Golowa70/CAR_BS_CONTROLLER_ST7920/README.md

# CAR_BS_CONTROLLER_ST7920
Контроллер дополнительного 
оборудования автомобиля описанного в https://github.com/Golowa70/CAR-BS-CONTROLLER-NEX
Используется то же железо но вместо nextion применён дисплей ST7920 + три кнопки
для навигации по меню.
