Golowa70/CAR_BS_CONTROLLER_ST7920/KiCad/Car_bs_controller_nex_mega__v3.pdf

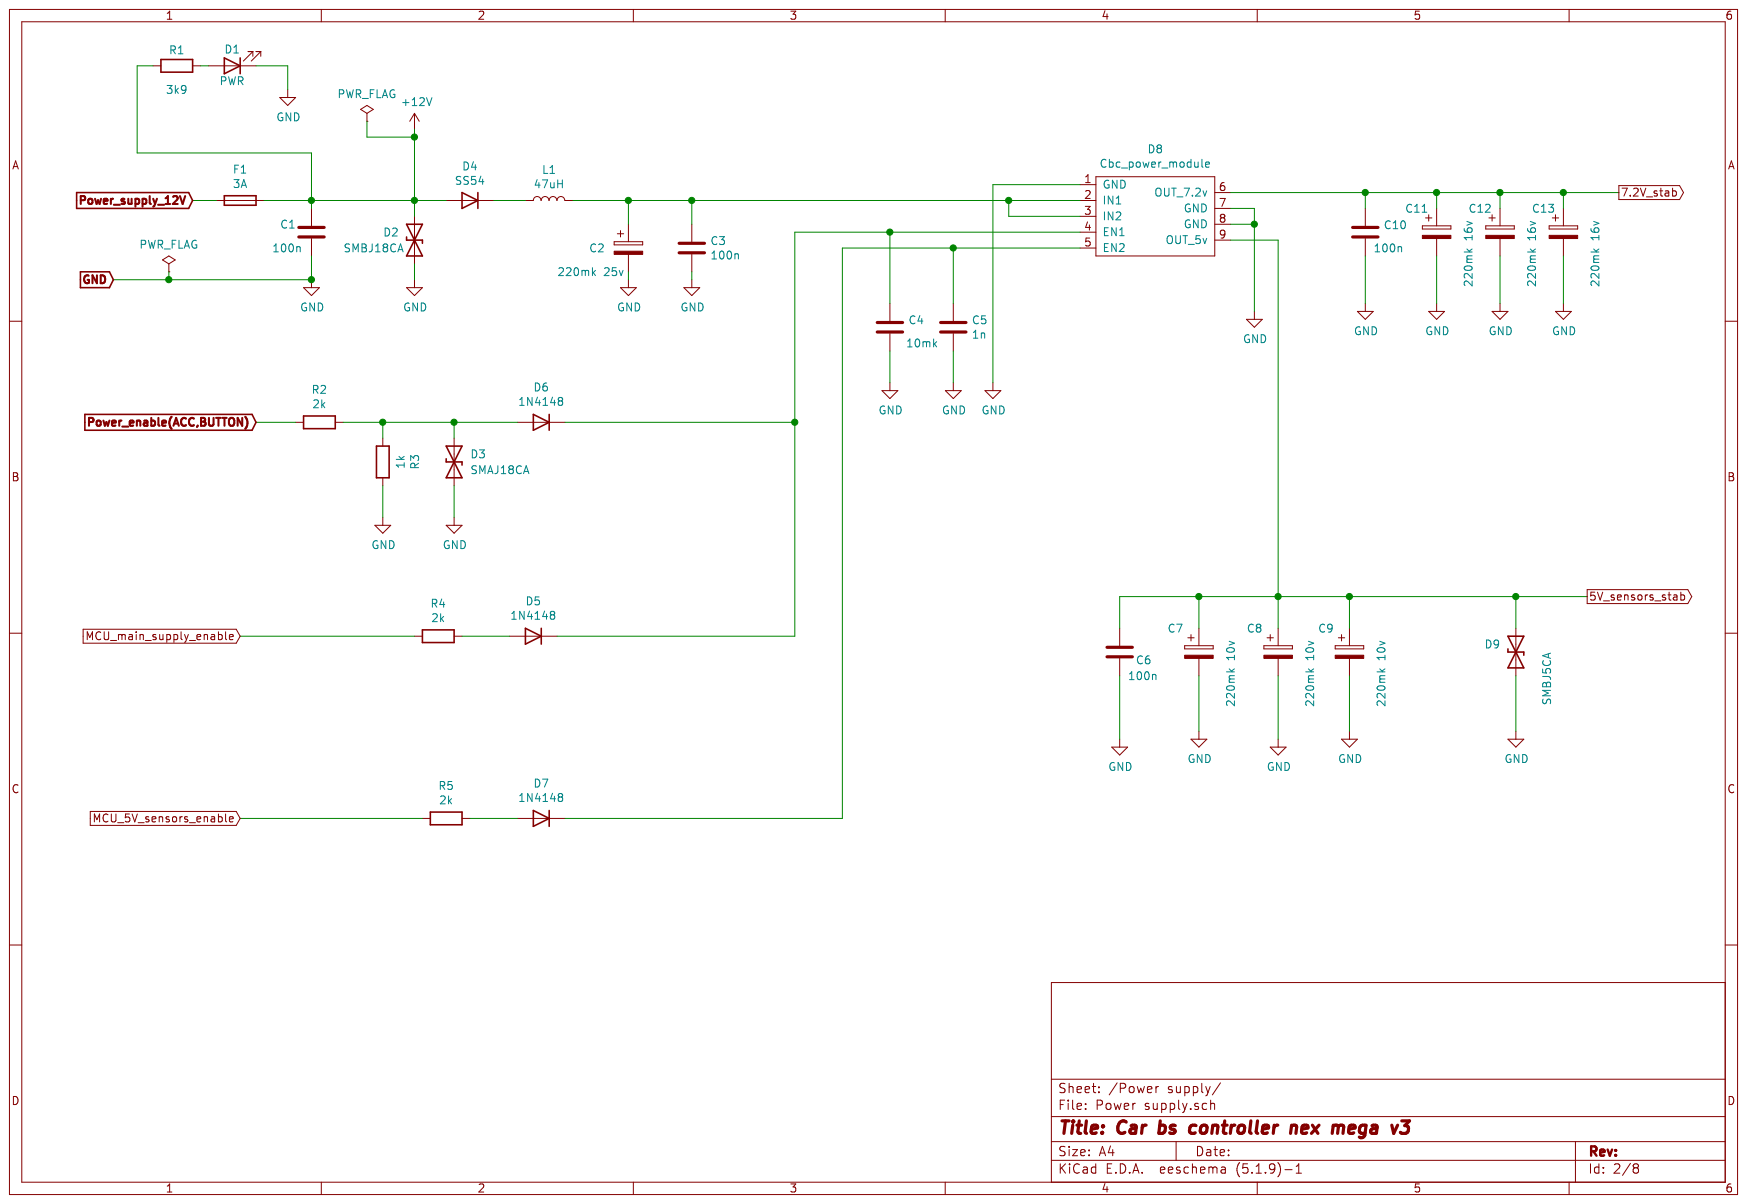
[picture p1: page 1]

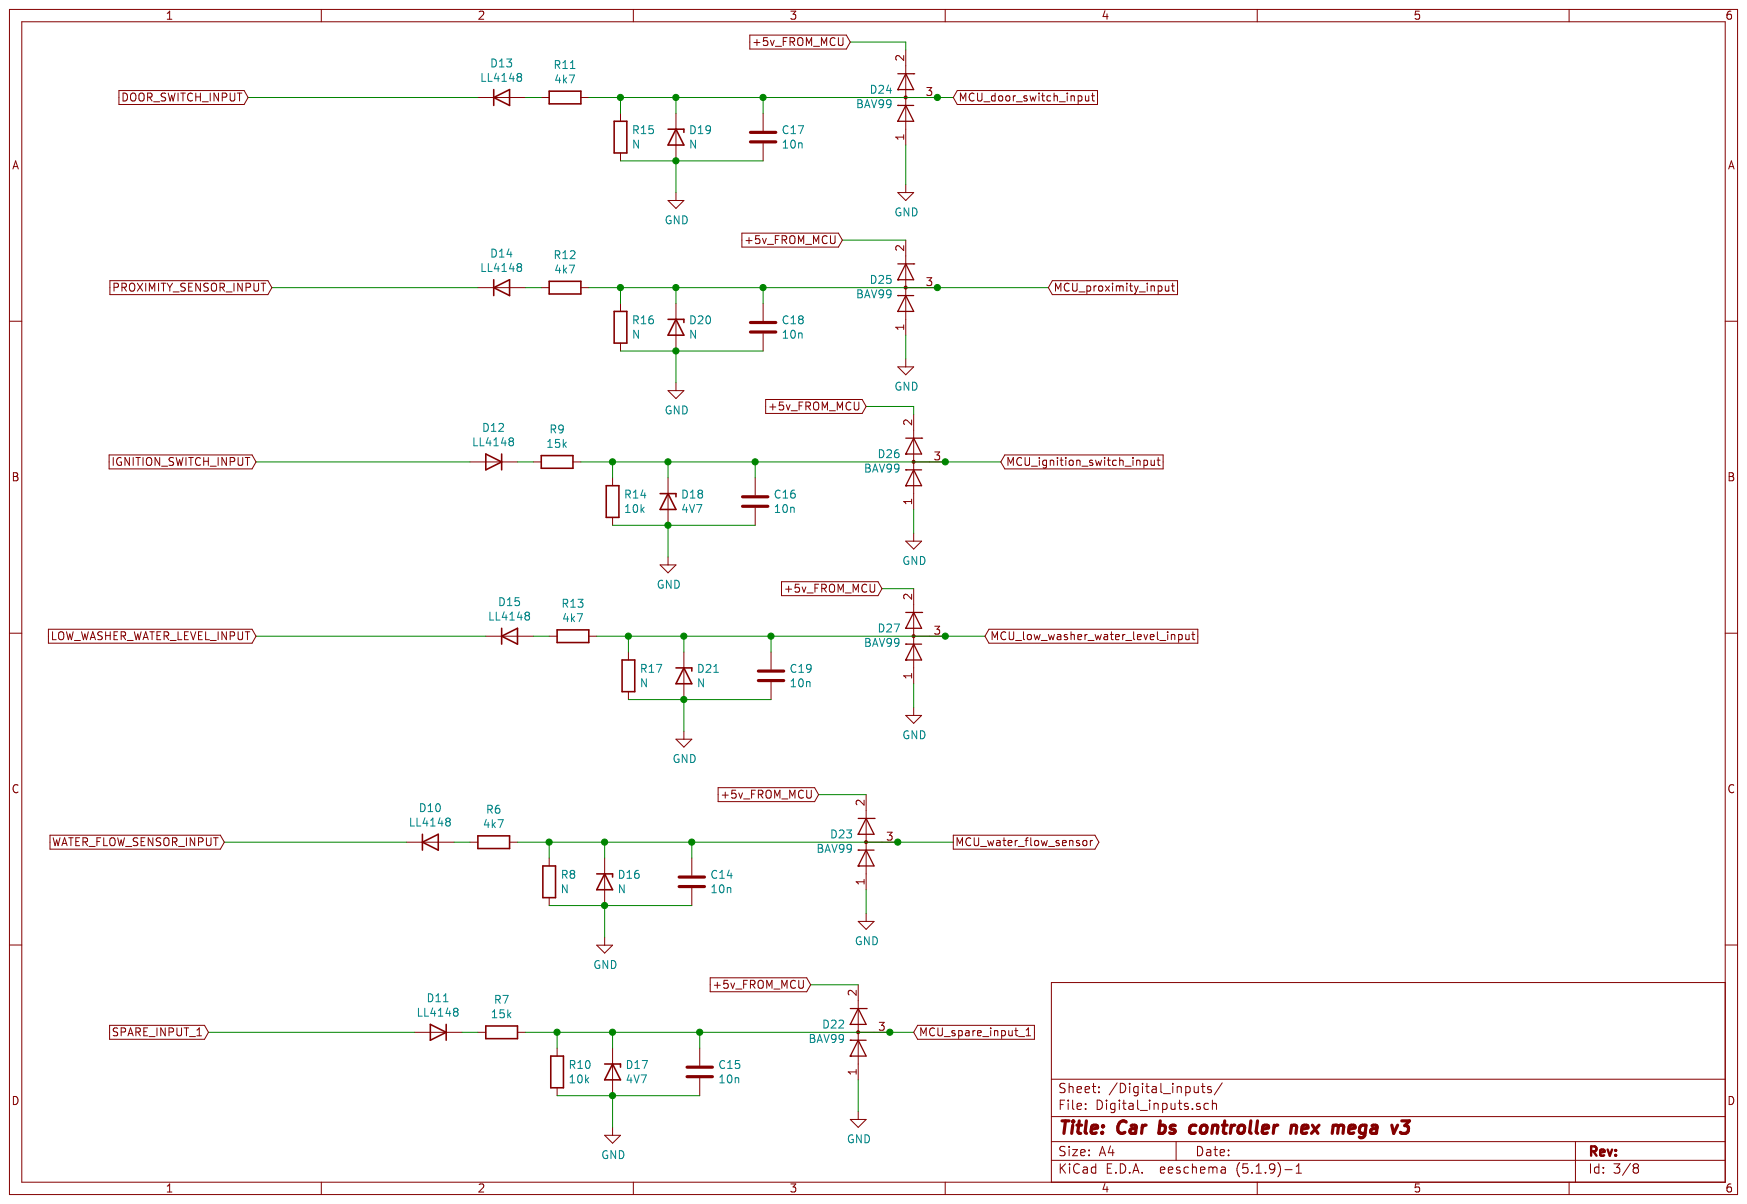
[picture p2: page 2]

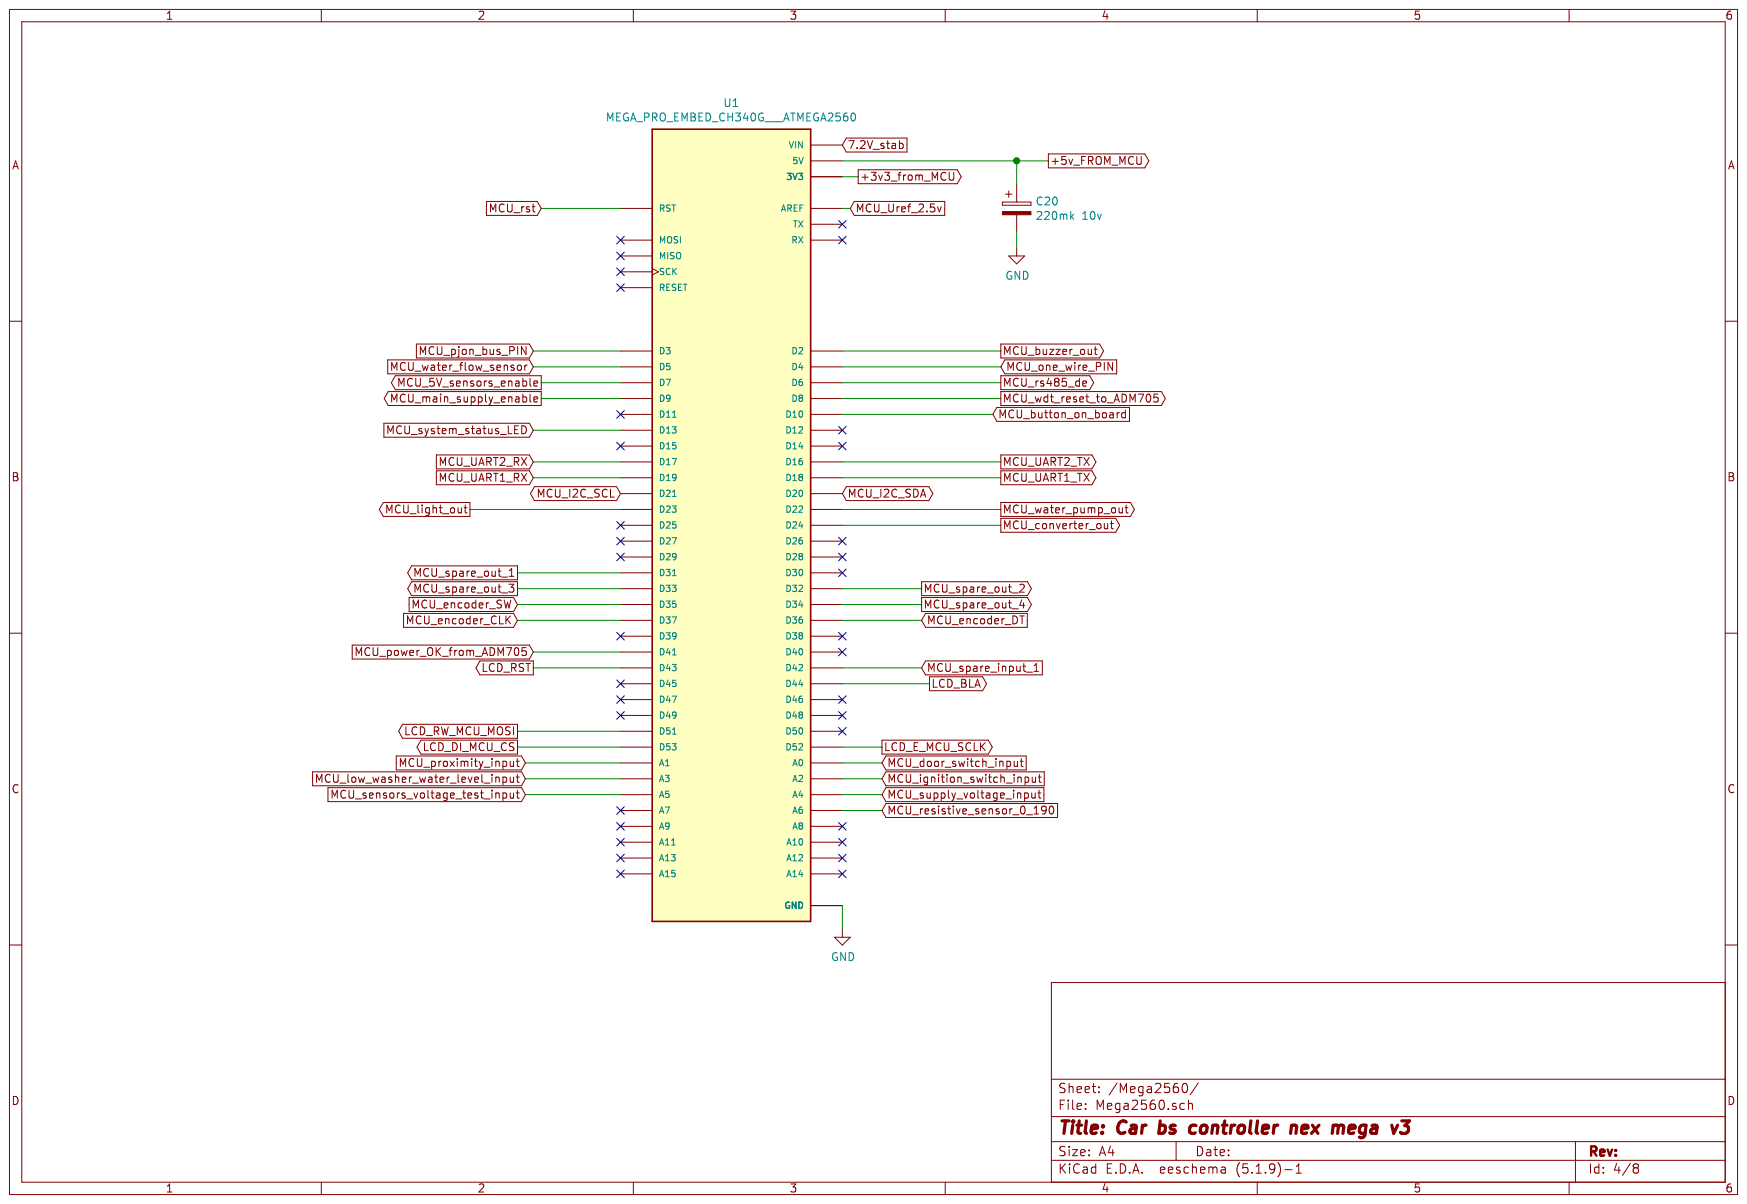
[picture p3: page 3]

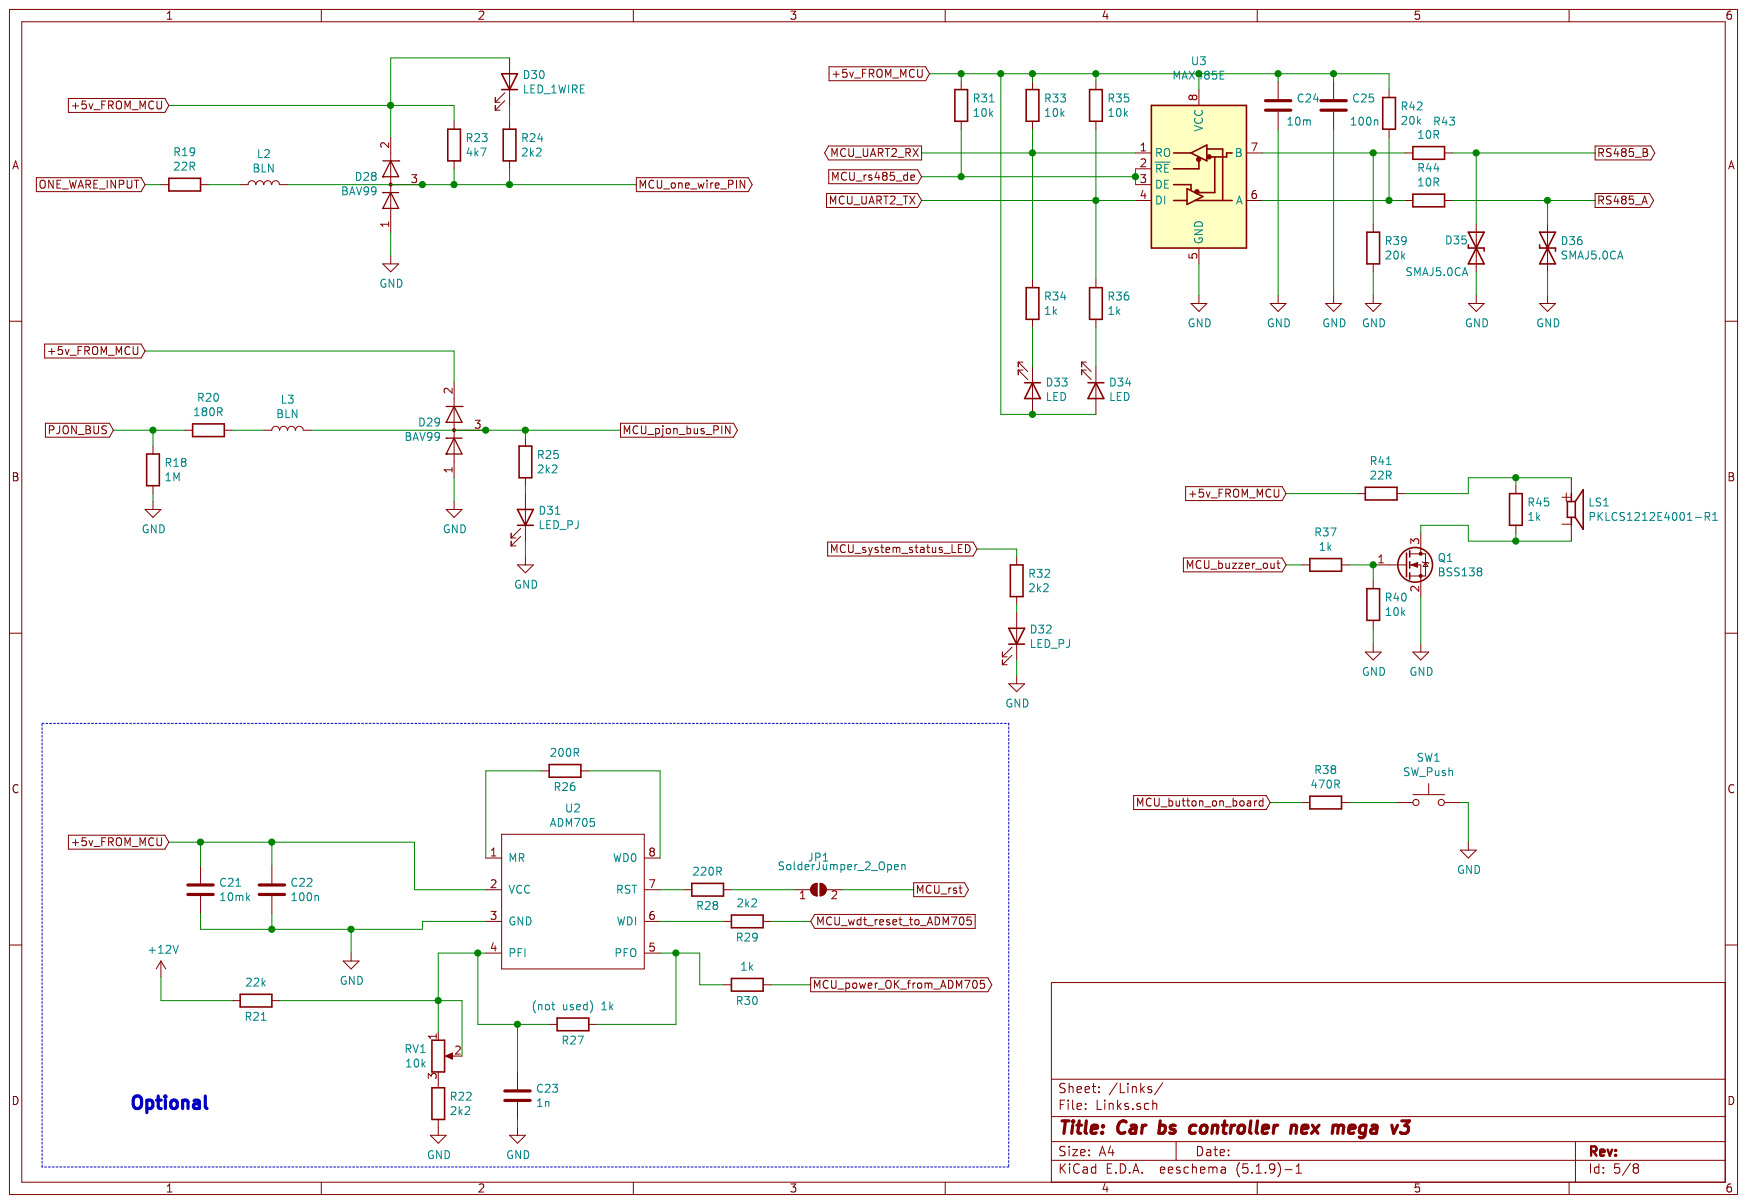
[picture p4: page 4]

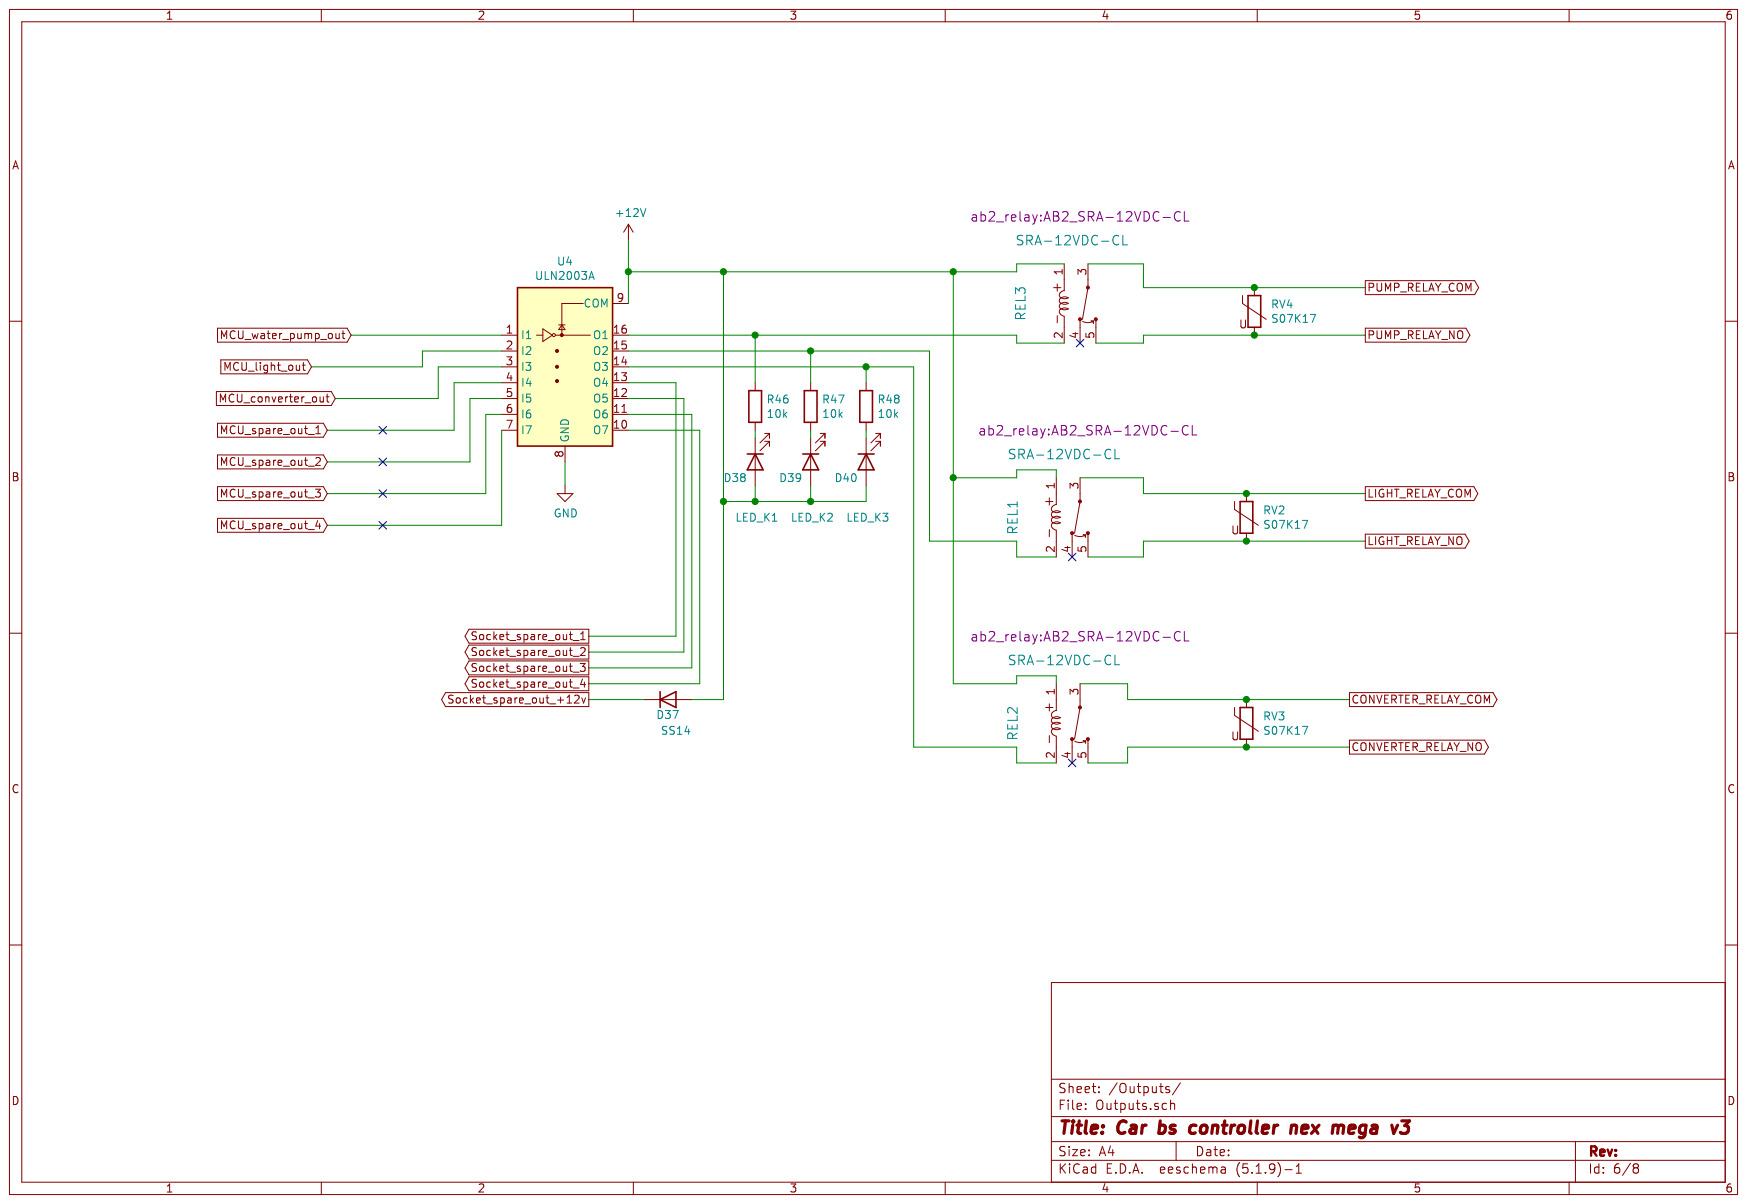
[picture p5: page 5]

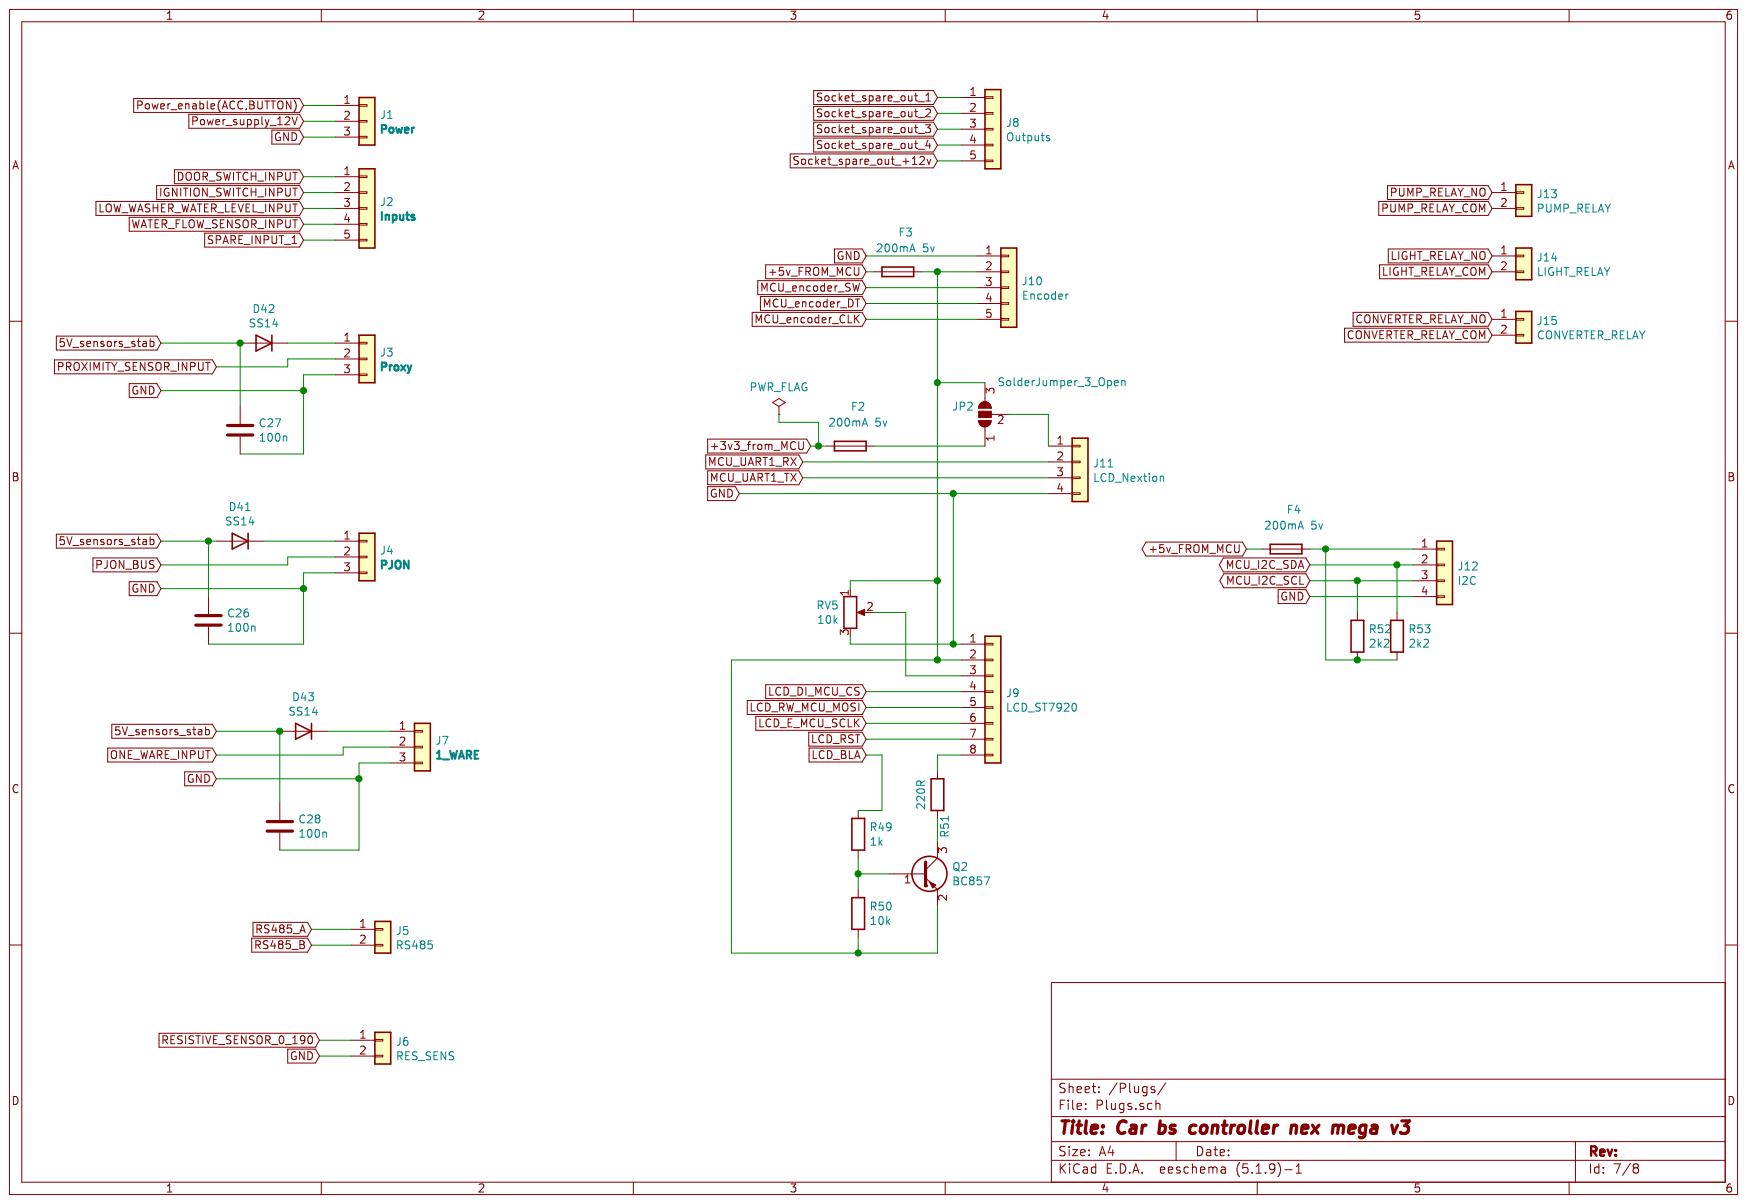
[picture p6: page 6]

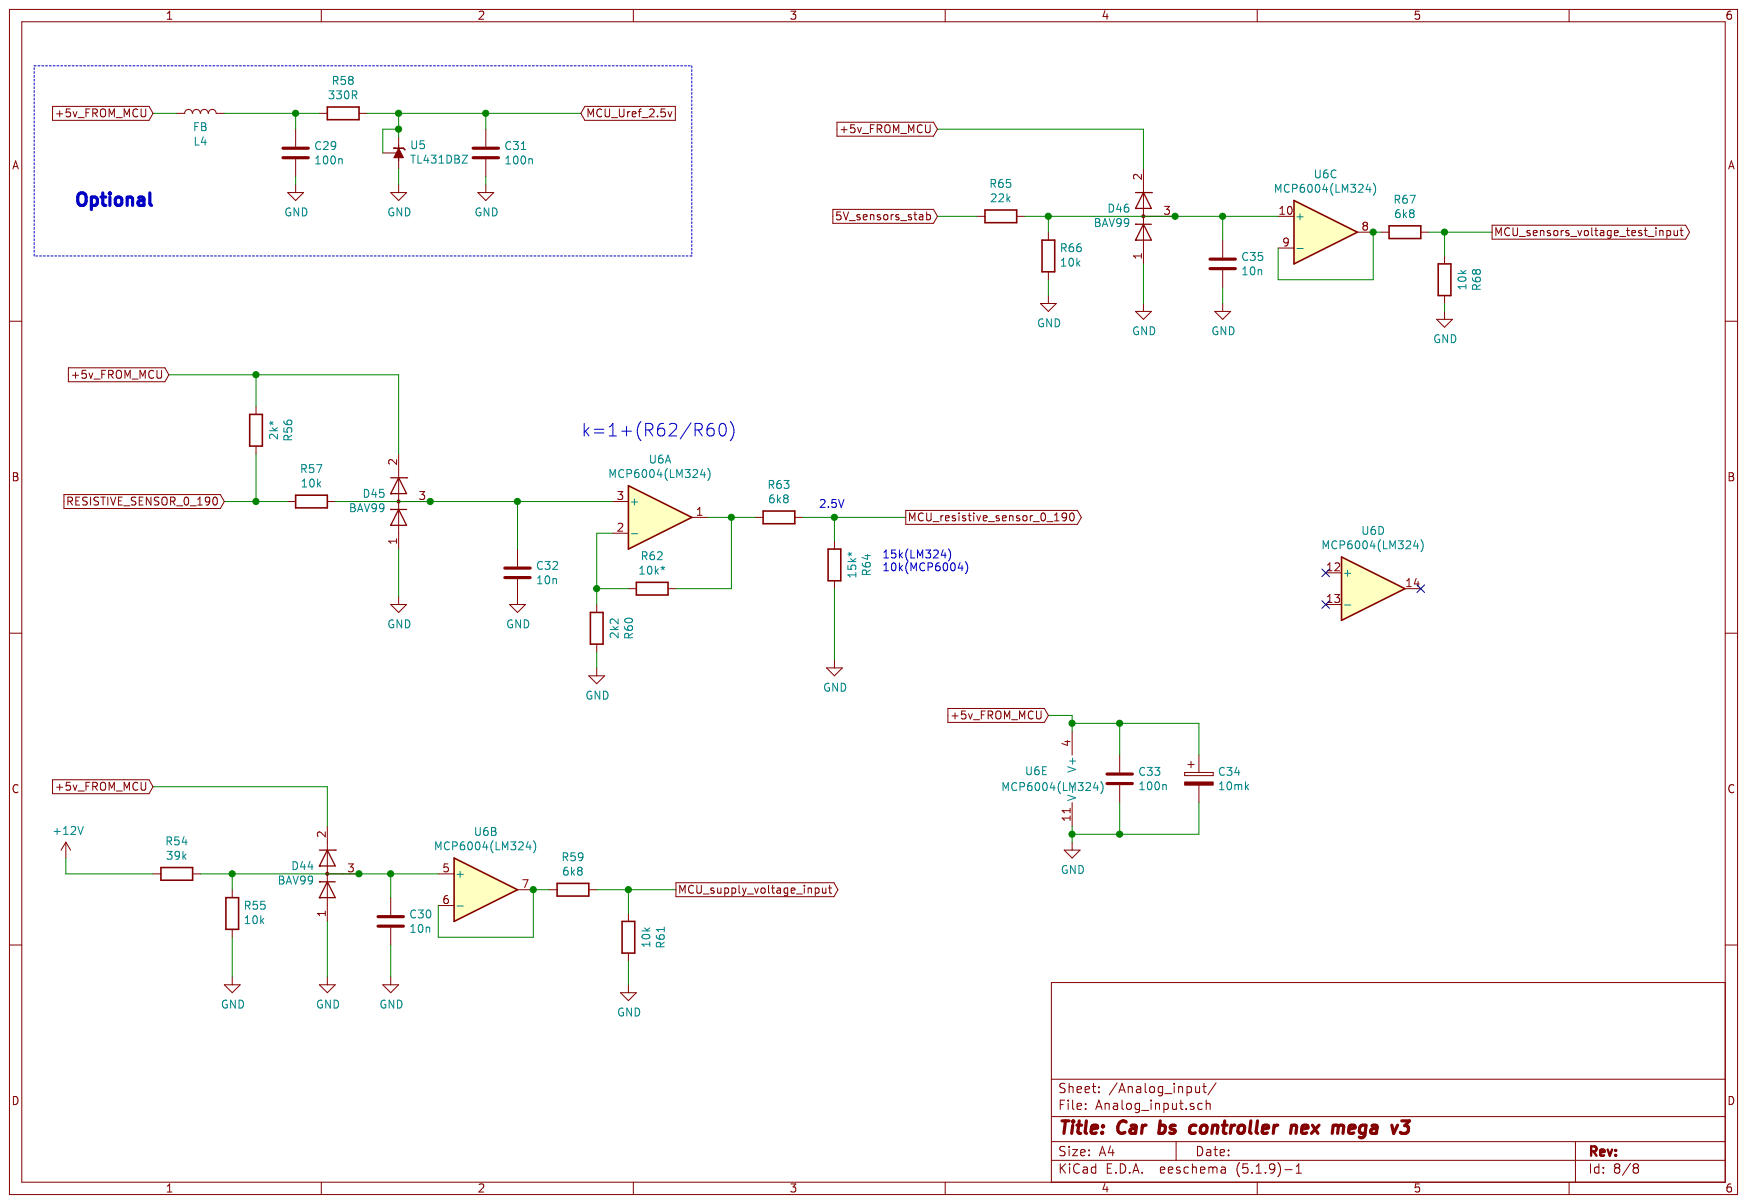
[picture p7: page 7]
