Golowa70/CAR_BS_CONTROLLER_ST7920/KiCad/Cbc_power_supply_module.pdf

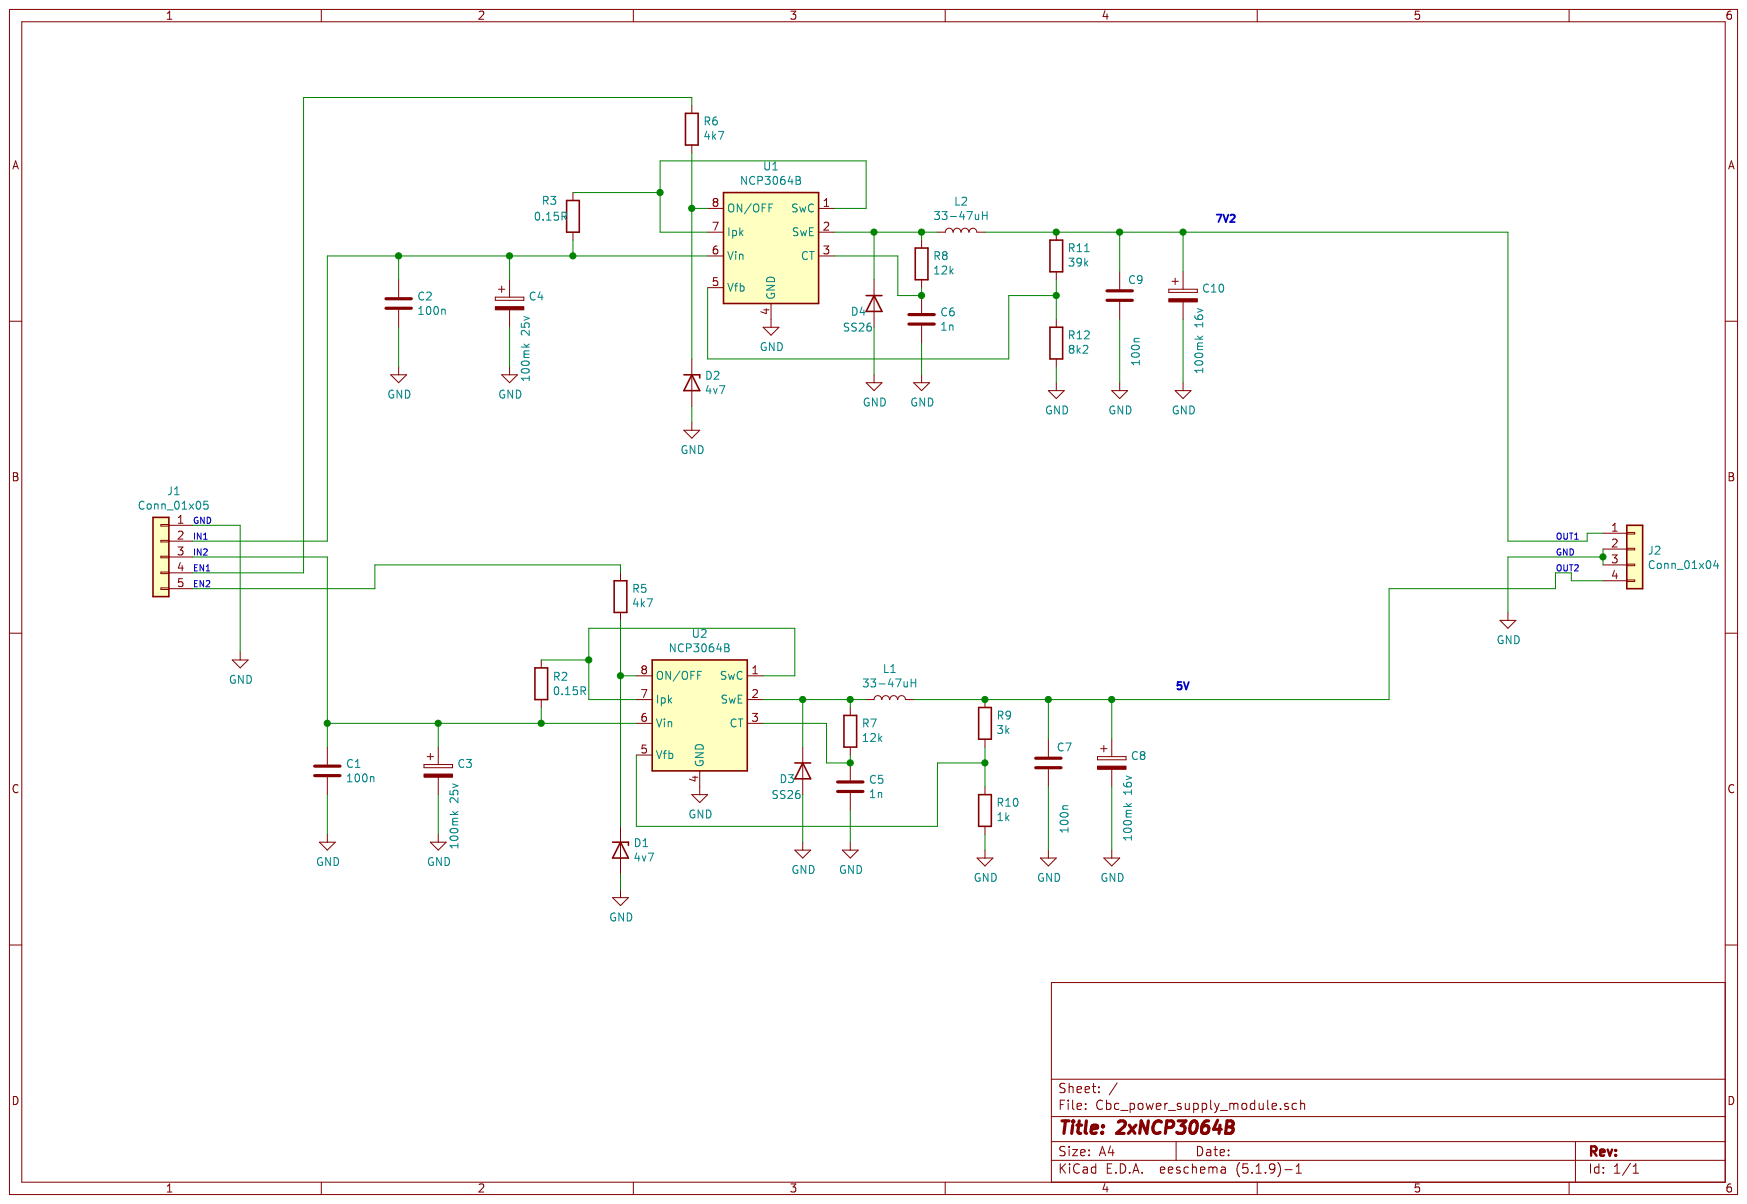
[picture p8: page 1]
