Golowa70/CAR_BS_CONTROLLER_ST7920/sPlan/CAR_BS_CONTROLLER_V3_connectors.pdf

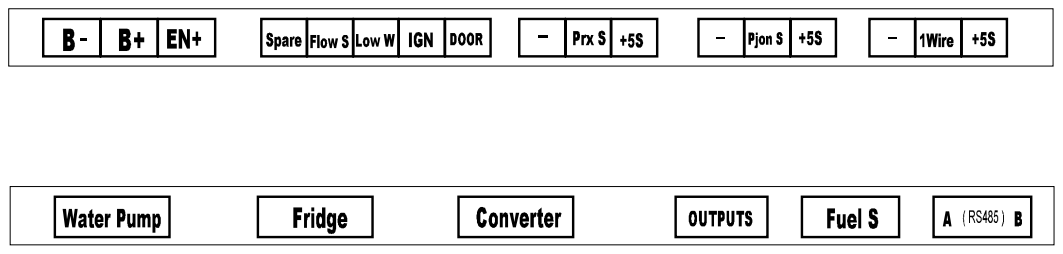
[picture p9: page 1]
