Golowa70/CAR_BS_CONTROLLER_ST7920/sPlan/CAR_BS_CONTROLLER_V3_diagram.pdf

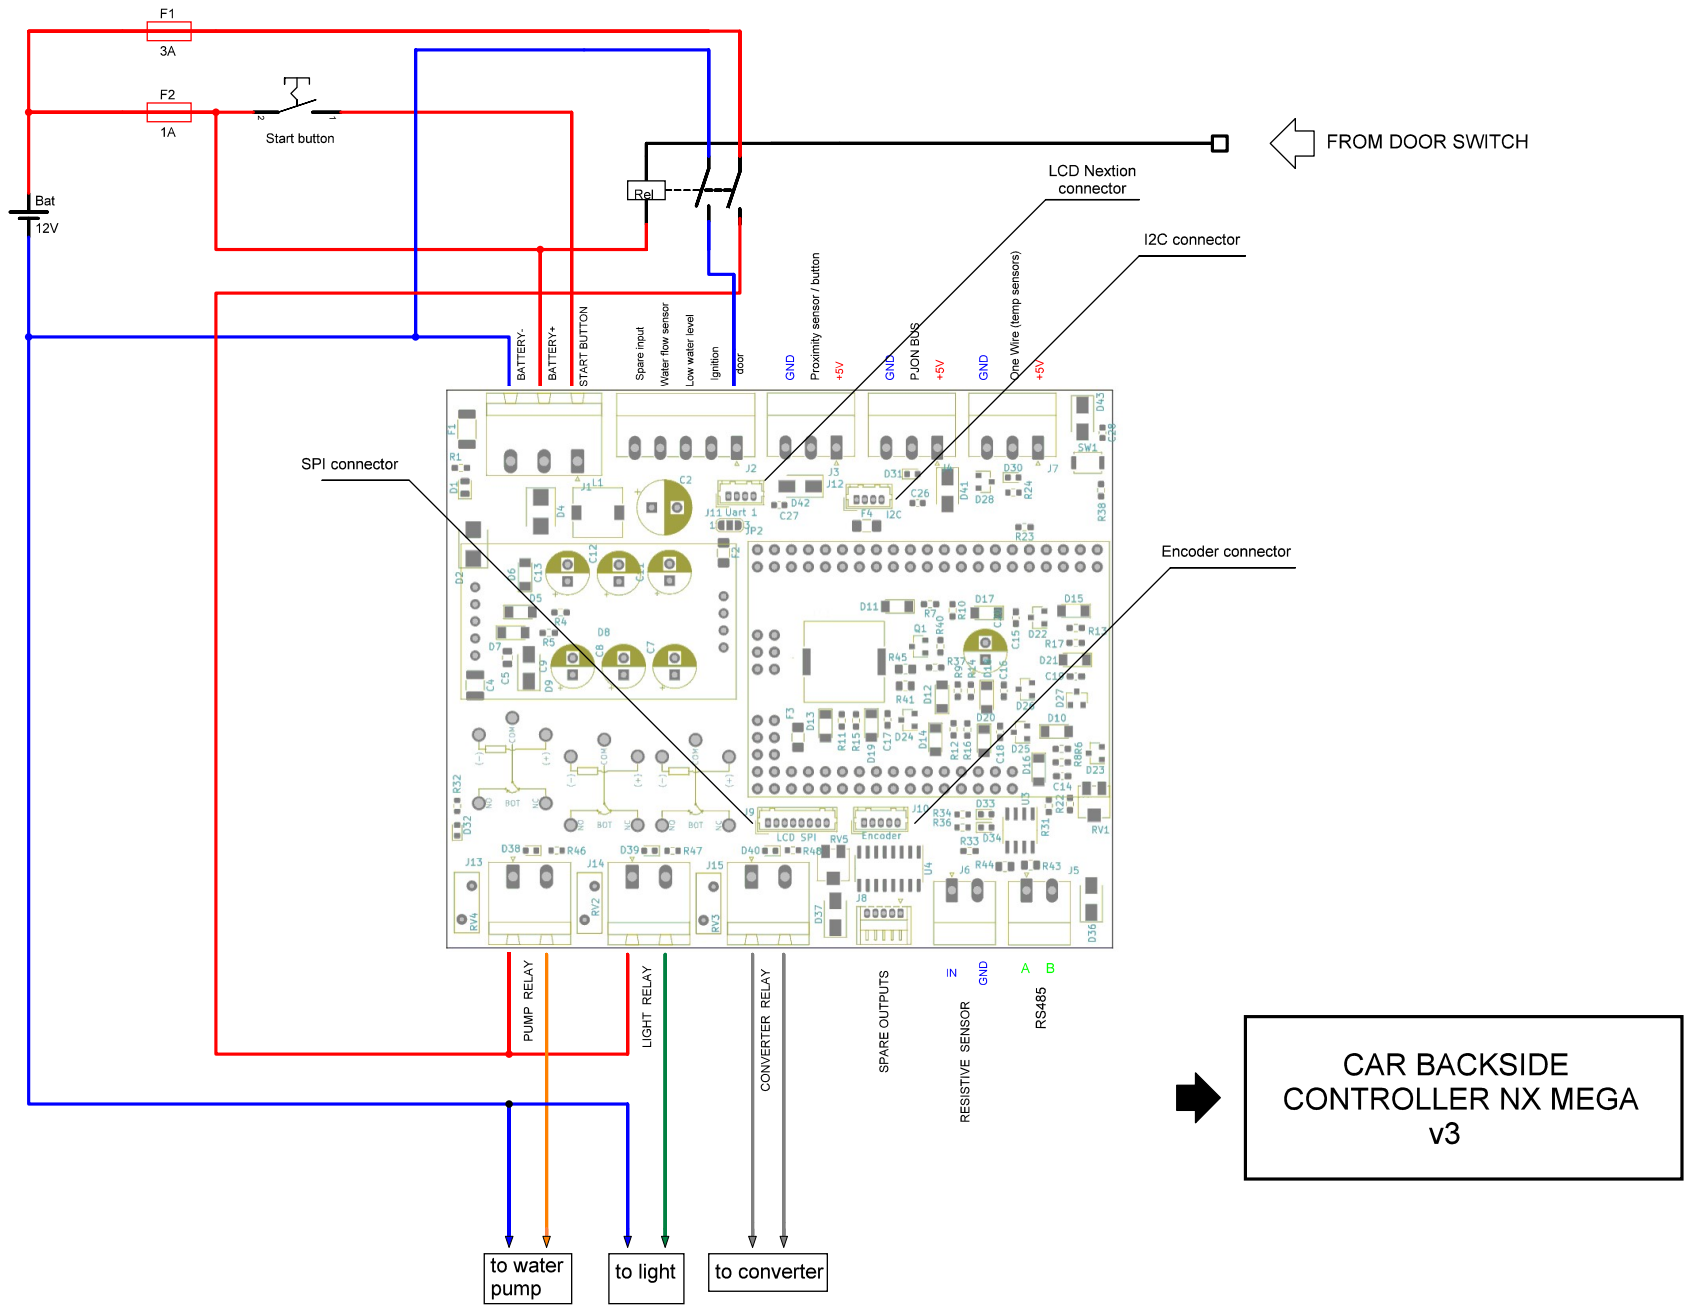
[picture p10: page 1]
