Golowa70/CAR_BS_CONTROLLER_ST7920/(list of files, drawings)

Other design files:
sPlan/Car_bs_controller_connectors.spl7
sPlan/Car_bs_controller_logo.spl7
sPlan/Car_bs_controller_nex_instal_diagram.spl7
