Golowa70/CAR_BS_CONTROLLER_ST7920/KiCad/Car_bs_controller_nex_mega/Car_bs_controller_nex_mega.kicad_pcb

## KiCad design KiCad/Car_bs_controller_nex_mega/Car_bs_controller_nex_mega.kicad_pcb (2022-05-16)

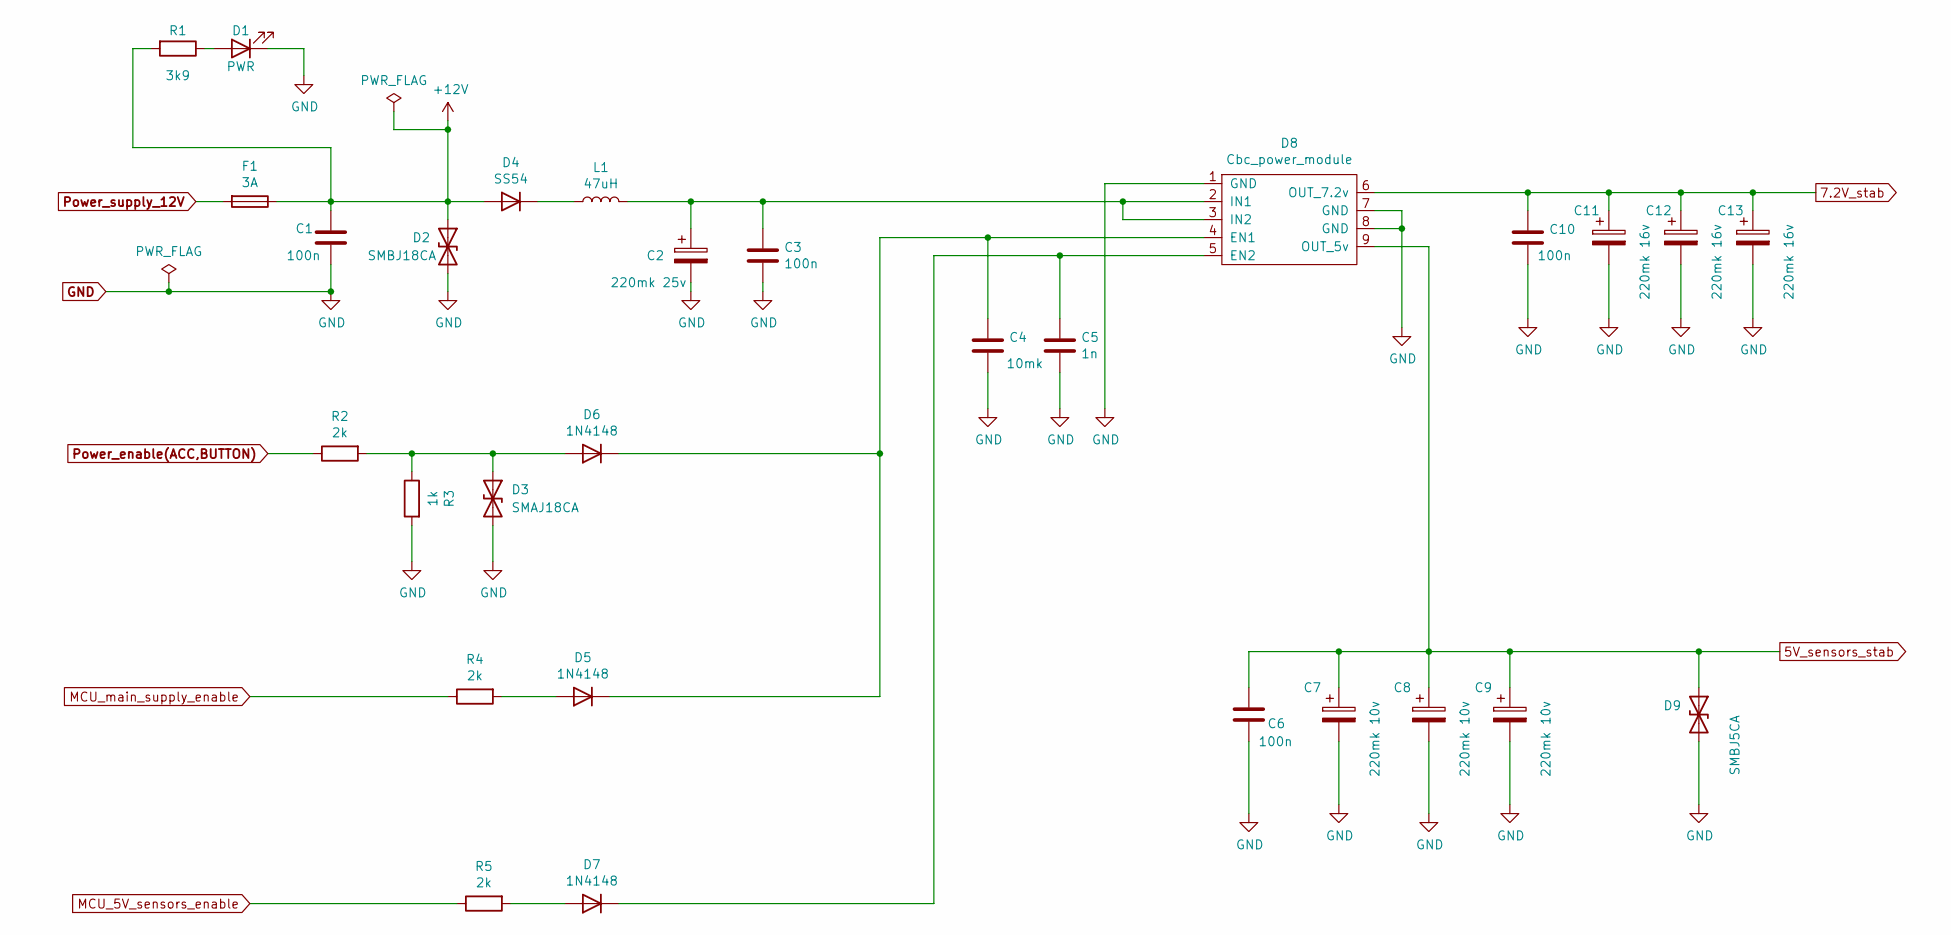
[picture p19: schematic Power supply.sch, Car bs controller nex mega v3]

Parts:
C1, C3, C6, C10: 100n; C_0805_2012Metric
C2: 220mk 25v; CP_Radial_D8.0mm_P3.80mm
C4: 10mk; C_1210_3225Metric_Pad1.33x2.70mm_HandSolder
C5: 1n; C_0805_2012Metric
C7, C8, C9: 220mk 10v; CP_Radial_D6.3mm_P2.50mm
C11, C12, C13: 220mk 16v; CP_Radial_D6.3mm_P2.50mm
D1: PWR; LED_0805_2012Metric
D2: SMBJ18CA; D_SMB
D3: SMAJ18CA; D_SMA
D4: SS54; D_SMB
D5, D6, D7: 1N4148; D_MiniMELF
D8: Cbc_power_module
D9: SMBJ5CA; D_SMA
F1: 3A; Fuse_2010_5025Metric
L1: 47uH; L_7.3x7.3_H4.5
R1: 3k9; R_0603_1608Metric_Pad0.98x0.95mm_HandSolder
R2, R4, R5: 2k; R_0603_1608Metric_Pad0.98x0.95mm_HandSolder
R3: 1k; R_0603_1608Metric_Pad0.98x0.95mm_HandSolder

Connections:
5V_sensors_stab: C6.1, C7.1, C8.1, C9.1, D8.9 (OUT_5v), D9.1 (A1); also elsewhere on the board
7.2V_stab: C10.1, C11.1, C12.1, C13.1, D8.6 (OUT_7.2v); also elsewhere on the board
+12V: C1.1, D2.1 (A1), D4.2 (A), F1.1, R1.2; also elsewhere on the board
GND: C1.2, C2.2, C3.2, C4.2, C5.2, C6.2, C7.2, C8.2, C9.2, C10.2, C11.2, C12.2, C13.2, D1.1 (K), D2.2 (A2), D3.2 (A2), D8.1 (GND), D8.7 (GND), D8.8 (GND), D9.2 (A2), R3.2; also elsewhere on the board
MCU_5V_sensors_enable: R5.1; also elsewhere on the board
MCU_main_supply_enable: R4.1; also elsewhere on the board
unnamed: C2.1, C3.1, D8.2 (IN1), D8.3 (IN2), L1.2
unnamed: C4.1, D5.1 (K), D6.1 (K), D8.4 (EN1)
unnamed: C5.1, D7.1 (K), D8.5 (EN2)
unnamed: D1.2 (A), R1.1
unnamed: D3.1 (A1), D6.2 (A), R2.2, R3.1
unnamed: D4.1 (K), L1.1
unnamed: D5.2 (A), R4.2
unnamed: D7.2 (A), R5.2
Power_enable(ACC,BUTTON): R2.1; also elsewhere on the board
Power_supply_12V: F1.2; also elsewhere on the board

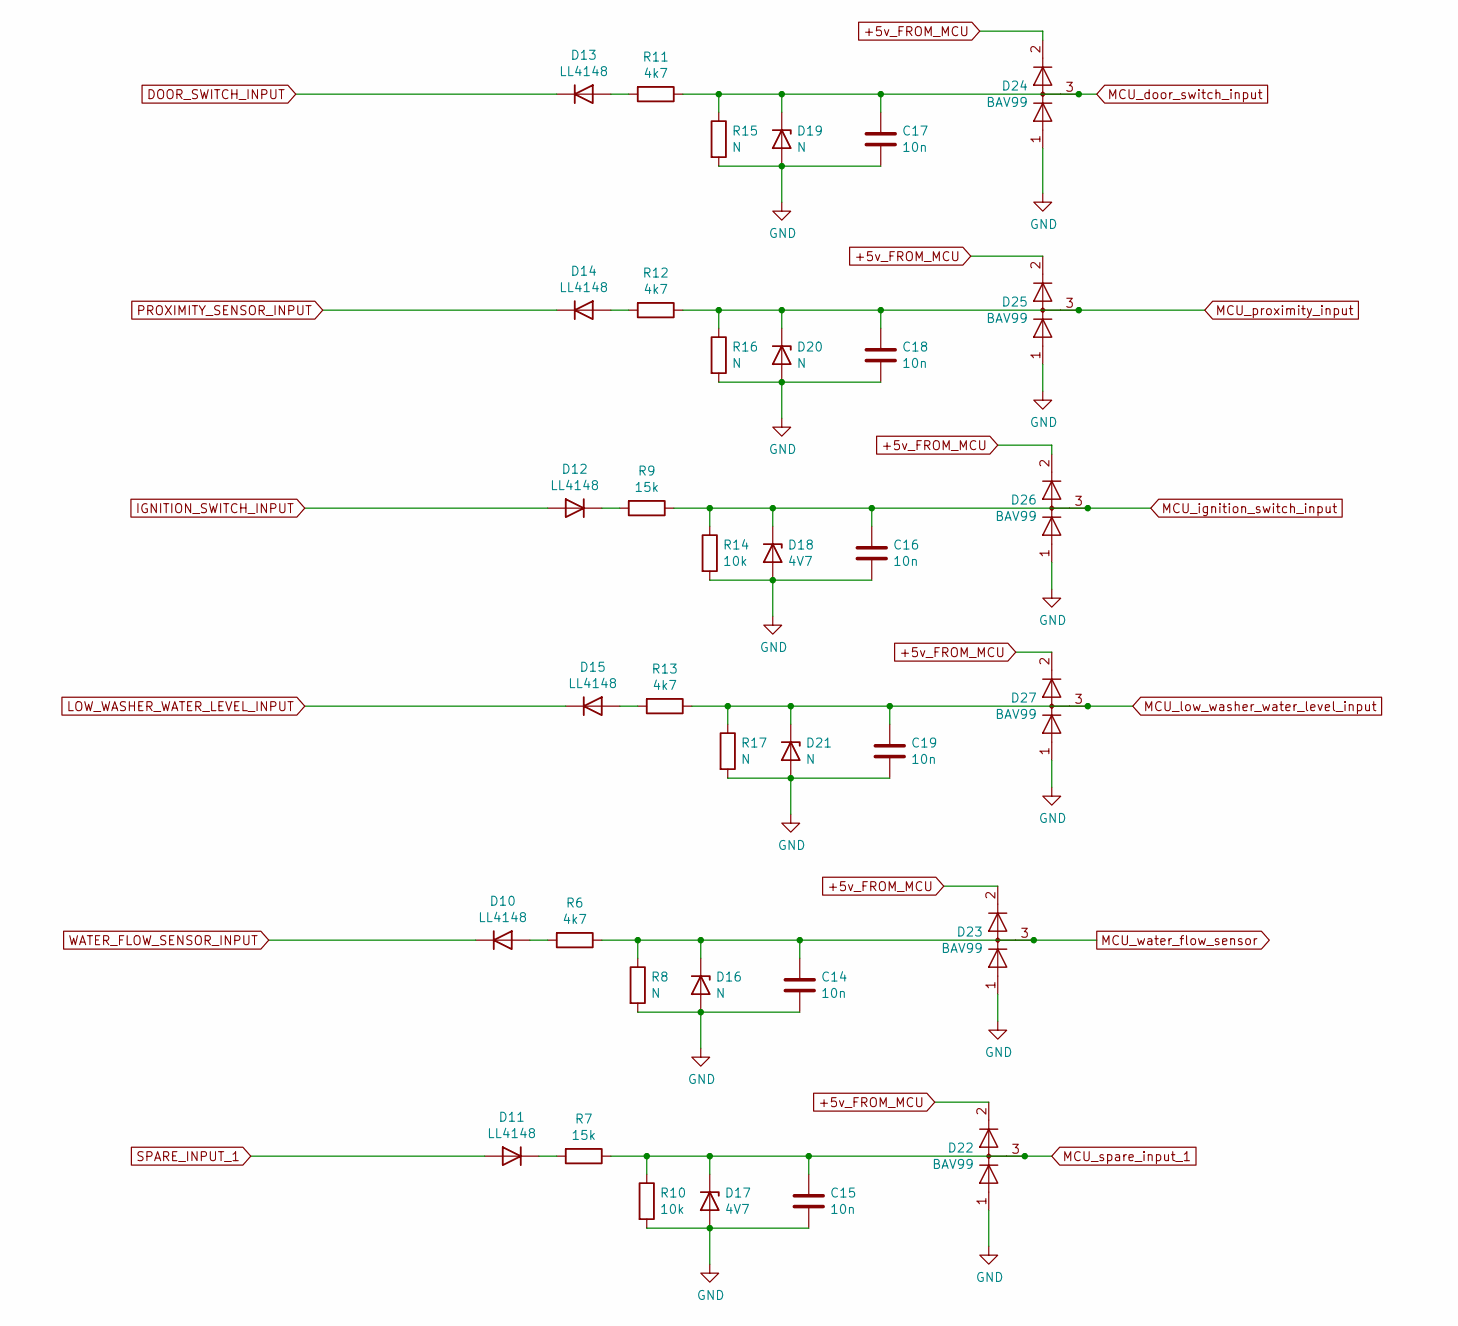
[picture p20: schematic Digital_inputs.sch, Car bs controller nex mega v3]

Parts:
C14, C15, C16, C17, C18, C19: 10n; C_0603_1608Metric_Pad1.08x0.95mm_HandSolder
D10, D11, D12, D13, D14, D15: LL4148; D_MiniMELF
D16, D19, D20, D21: N; D_MiniMELF
D17, D18: 4V7; D_MiniMELF
D22, D23, D24, D25, D26, D27: BAV99; SOT-23
R6, R11, R12, R13: 4k7; R_0603_1608Metric_Pad0.98x0.95mm_HandSolder
R7, R9: 15k; R_0603_1608Metric_Pad0.98x0.95mm_HandSolder
R8, R15, R16, R17: N; R_0603_1608Metric_Pad0.98x0.95mm_HandSolder
R10, R14: 10k; R_0603_1608Metric_Pad0.98x0.95mm_HandSolder

Connections:
+5v_FROM_MCU: D22.2 (A), D23.2 (A), D24.2 (A), D25.2 (A), D26.2 (A), D27.2 (A); also elsewhere on the board
DOOR_SWITCH_INPUT: D13.1 (K); also elsewhere on the board
GND: C14.2, C15.2, C16.2, C17.2, C18.2, C19.2, D16.2 (A), D17.2 (A), D18.2 (A), D19.2 (A), D20.2 (A), D21.2 (A), D22.1 (K), D23.1 (K), D24.1 (K), D25.1 (K), D26.1 (K), D27.1 (K), R8.2, R10.2, R14.2, R15.2, R16.2, R17.2; also elsewhere on the board
IGNITION_SWITCH_INPUT: D12.2 (A); also elsewhere on the board
LOW_WASHER_WATER_LEVEL_INPUT: D15.1 (K); also elsewhere on the board
MCU_door_switch_input: C17.1, D19.1 (K), D24.3 (K), R11.1, R15.1; also elsewhere on the board
MCU_ignition_switch_input: C16.1, D18.1 (K), D26.3 (K), R9.1, R14.1; also elsewhere on the board
MCU_low_washer_water_level_input: C19.1, D21.1 (K), D27.3 (K), R13.1, R17.1; also elsewhere on the board
MCU_proximity_input: C18.1, D20.1 (K), D25.3 (K), R12.1, R16.1; also elsewhere on the board
MCU_spare_input_1: C15.1, D17.1 (K), D22.3 (K), R7.1, R10.1; also elsewhere on the board
MCU_water_flow_sensor: C14.1, D16.1 (K), D23.3 (K), R6.1, R8.1; also elsewhere on the board
unnamed: D10.2 (A), R6.2
unnamed: D11.1 (K), R7.2
unnamed: D12.1 (K), R9.2
unnamed: D13.2 (A), R11.2
unnamed: D14.2 (A), R12.2
unnamed: D15.2 (A), R13.2
PROXIMITY_SENSOR_INPUT: D14.1 (K); also elsewhere on the board
SPARE_INPUT_1: D11.2 (A); also elsewhere on the board
WATER_FLOW_SENSOR_INPUT: D10.1 (K); also elsewhere on the board

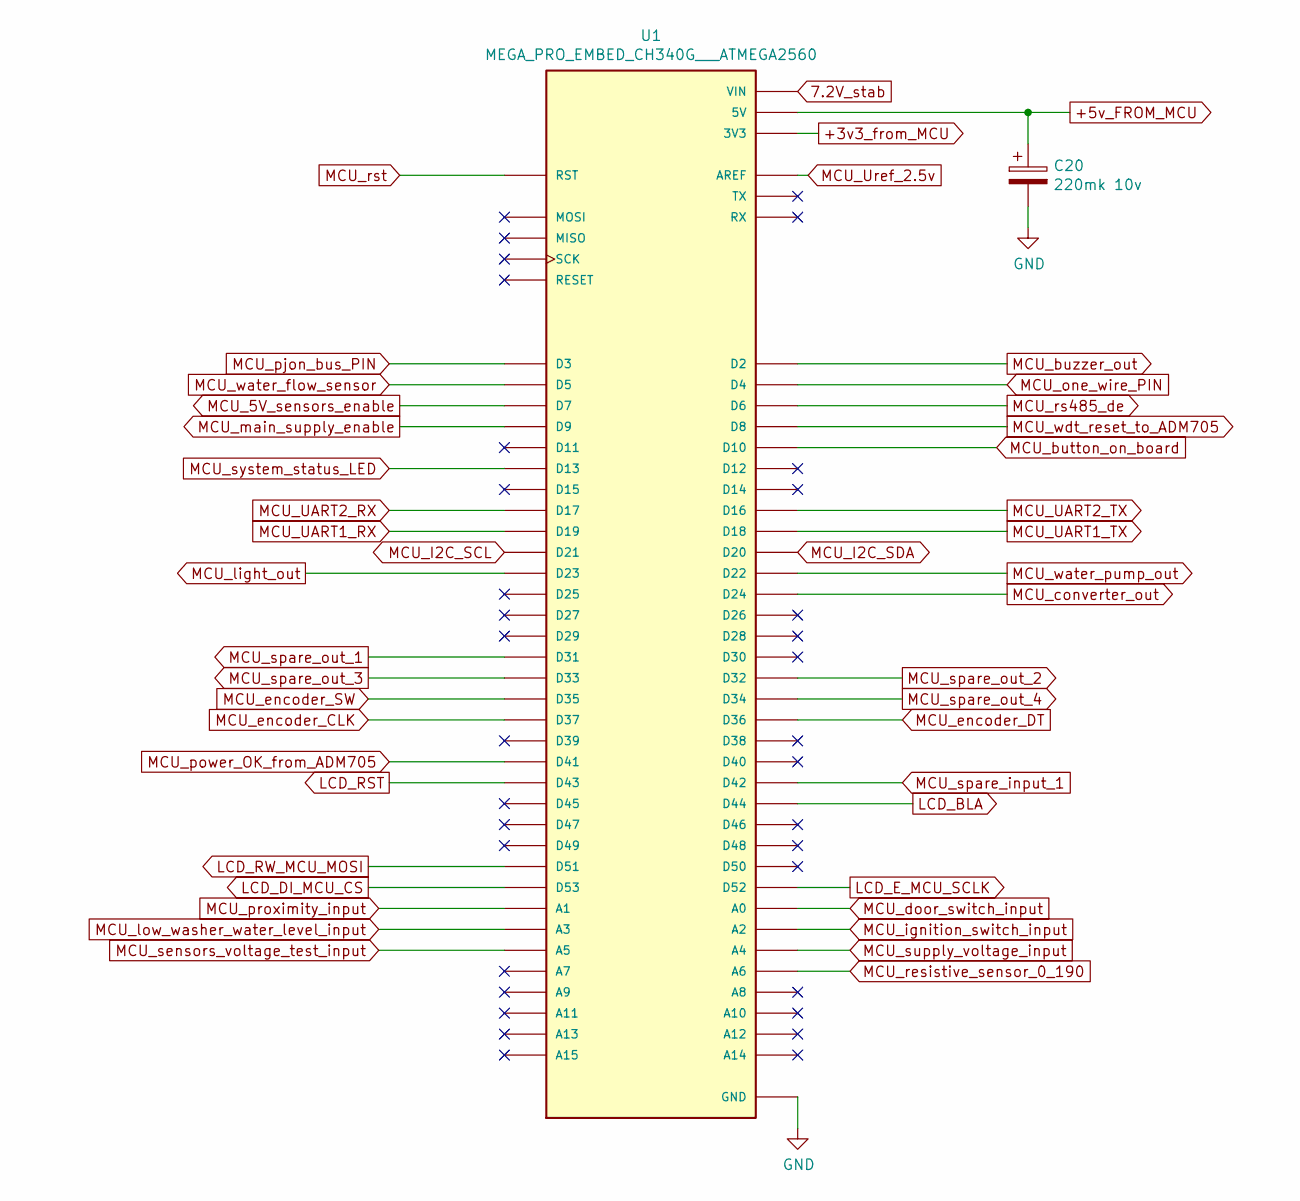
[picture p21: schematic Mega2560.sch, Car bs controller nex mega v3]

Parts:
C20: 220mk 10v; CP_Radial_D6.3mm_P2.50mm
U1: MEGA_PRO_EMBED_CH340G___ATMEGA2560; _ATMEGA2560; PARTREV 12/May/2017

Connections:
7.2V_stab: U1.VIN_1 (VIN); also elsewhere on the board
+3v3_from_MCU: U1.3V3_1 (3V3), U1.3V3_2 (3V3); also elsewhere on the board
+5v_FROM_MCU: C20.1, U1.5V_1 (5V); also elsewhere on the board
GND: C20.2, U1.GND_1 (GND), U1.GND_2 (GND), U1.GND_3 (GND); also elsewhere on the board
LCD_BLA: U1.D44; also elsewhere on the board
LCD_E_MCU_SCLK: U1.D52; also elsewhere on the board
LCD_RST: U1.D43; also elsewhere on the board
LCD_RW_MCU_MOSI: U1.D51; also elsewhere on the board
MCU_5V_sensors_enable: U1.D7; also elsewhere on the board
MCU_I2C_SCL: U1.D21; also elsewhere on the board
MCU_I2C_SDA: U1.D20; also elsewhere on the board
MCU_UART1_RX: U1.D19; also elsewhere on the board
MCU_UART1_TX: U1.D18; also elsewhere on the board
MCU_UART2_RX: U1.D17; also elsewhere on the board
MCU_UART2_TX: U1.D16; also elsewhere on the board
MCU_Uref_2.5v: U1.AREF; also elsewhere on the board
MCU_button_on_board: U1.D10; also elsewhere on the board
MCU_buzzer_out: U1.D2; also elsewhere on the board
MCU_converter_out: U1.D24; also elsewhere on the board
MCU_door_switch_input: U1.A0; also elsewhere on the board
MCU_encoder_CLK: U1.D37; also elsewhere on the board
MCU_encoder_DT: U1.D36; also elsewhere on the board
MCU_encoder_SW: U1.D35; also elsewhere on the board
MCU_ignition_switch_input: U1.A2; also elsewhere on the board
MCU_light_out: U1.D23; also elsewhere on the board
MCU_low_washer_water_level_input: U1.A3; also elsewhere on the board
MCU_main_supply_enable: U1.D9; also elsewhere on the board
MCU_one_wire_PIN: U1.D4; also elsewhere on the board
MCU_pjon_bus_PIN: U1.D3; also elsewhere on the board
MCU_power_OK_from_ADM705: U1.D41; also elsewhere on the board
MCU_proximity_input: U1.A1; also elsewhere on the board
MCU_resistive_sensor_0_190: U1.A6; also elsewhere on the board
MCU_rs485_de: U1.D6; also elsewhere on the board
MCU_rst: U1.RST; also elsewhere on the board
MCU_sensors_voltage_test_input: U1.A5; also elsewhere on the board
MCU_spare_input_1: U1.D42; also elsewhere on the board
MCU_spare_out_1: U1.D31; also elsewhere on the board
MCU_spare_out_2: U1.D32; also elsewhere on the board
MCU_spare_out_3: U1.D33; also elsewhere on the board
MCU_spare_out_4: U1.D34; also elsewhere on the board
MCU_supply_voltage_input: U1.A4; also elsewhere on the board
MCU_system_status_LED: U1.D13; also elsewhere on the board
MCU_water_flow_sensor: U1.D5; also elsewhere on the board
MCU_water_pump_out: U1.D22; also elsewhere on the board
MCU_wdt_reset_to_ADM705: U1.D8; also elsewhere on the board

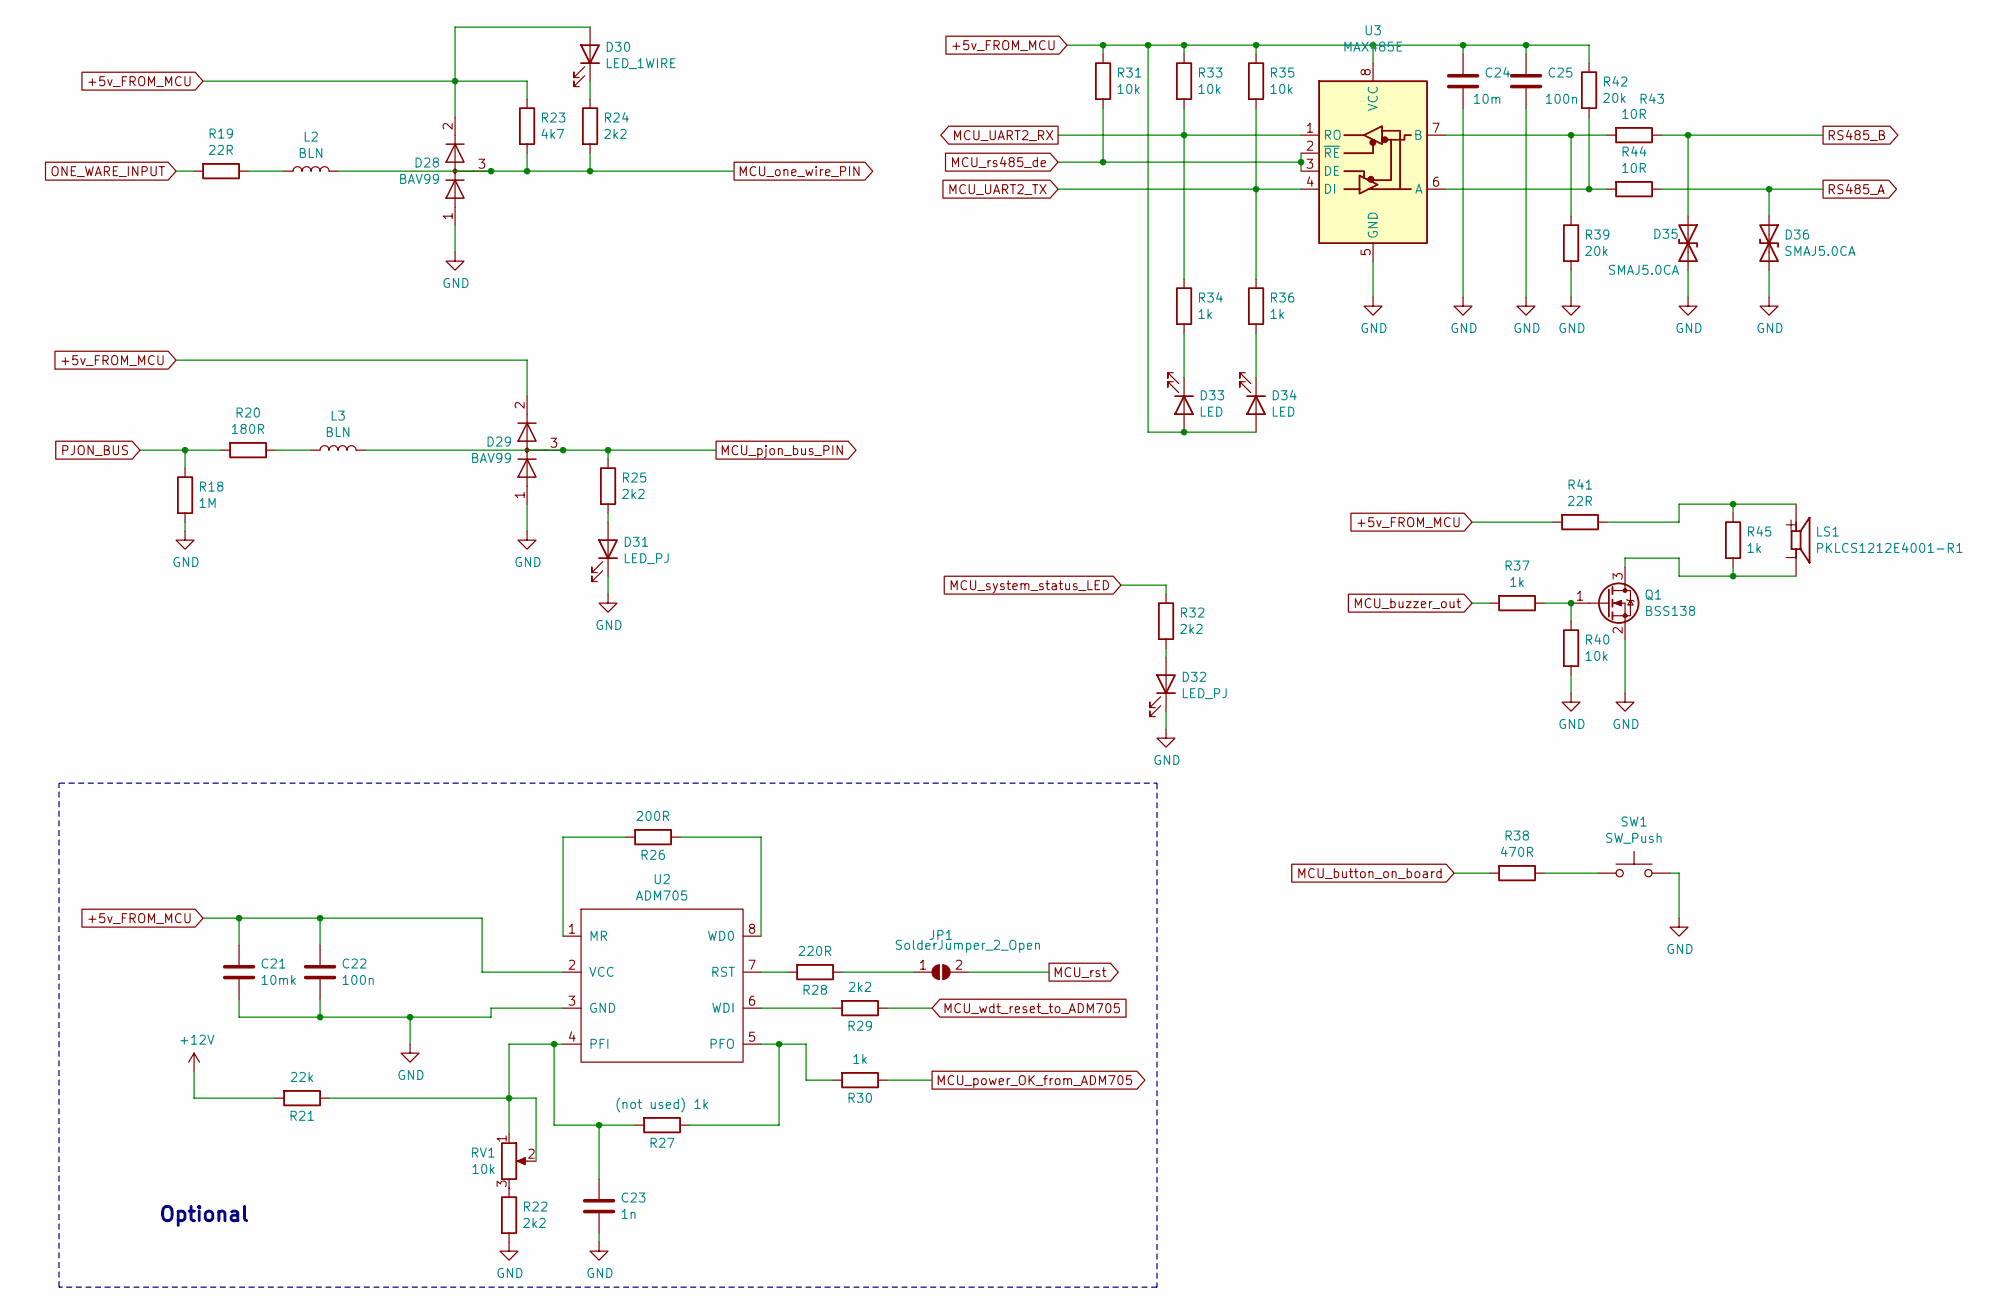
[picture p22: schematic Links.sch, Car bs controller nex mega v3]

Parts:
C21: 10mk; CP_EIA-7343-15_Kemet-W_Pad2.25x2.55mm_HandSolder
C22: 100n; R_0603_1608Metric
C23: 1n; R_0603_1608Metric_Pad0.98x0.95mm_HandSolder
C24: 10m; C_1210_3225Metric_Pad1.33x2.70mm_HandSolder
C25: 100n; C_0603_1608Metric_Pad1.08x0.95mm_HandSolder
D28, D29: BAV99; SOT-23
D30: LED_1WIRE; LED_0603_1608Metric
D31, D32: LED_PJ; LED_0603_1608Metric
D33, D34: LED; LED_0603_1608Metric
D35, D36: SMAJ5.0CA; D_SMA
JP1: SolderJumper_2_Open; SolderJumper-2_P1.3mm_Open_RoundedPad1.0x1.5mm
L2, L3: BLN; L_0805_2012Metric_Pad1.15x1.40mm_HandSolder
LS1: PKLCS1212E4001-R1; SPKR_PKLCS1212E4001-R1; PARTREV January 22, 2018
Q1: BSS138; SOT-23
R18: 1M; R_0805_2012Metric
R19, R41: 22R; R_0805_2012Metric
R20: 180R; R_0805_2012Metric
R21: 22k; R_0603_1608Metric_Pad0.98x0.95mm_HandSolder
R22, R29: 2k2; R_0603_1608Metric_Pad0.98x0.95mm_HandSolder
R23: 4k7; R_0603_1608Metric_Pad0.98x0.95mm_HandSolder
R24, R25, R32: 2k2; R_0603_1608Metric
R26: 200R; R_0603_1608Metric_Pad0.98x0.95mm_HandSolder
R27: (not used) 1k; R_0603_1608Metric_Pad0.98x0.95mm_HandSolder
R28: 220R; R_0603_1608Metric_Pad0.98x0.95mm_HandSolder
R30, R37: 1k; R_0603_1608Metric_Pad0.98x0.95mm_HandSolder
R31, R33, R35, R40: 10k; R_0603_1608Metric_Pad0.98x0.95mm_HandSolder
R34, R36: 1k; R_0603_1608Metric
R38: 470R; R_0603_1608Metric_Pad0.98x0.95mm_HandSolder
R39, R42: 20k; R_0603_1608Metric_Pad0.98x0.95mm_HandSolder
R43, R44: 10R; R_0805_2012Metric
R45: 1k; R_0805_2012Metric_Pad1.20x1.40mm_HandSolder
RV1: 10k; Potentiometer_Bourns_3314J_Vertical
SW1: SW_Push; SW_Push_SPST_NO_Alps_SKRK
U2: ADM705; SOIC-8_3.9x4.9mm_P1.27mm
U3: MAX485E; SOIC-8_3.9x4.9mm_P1.27mm

Connections:
+5v_FROM_MCU: C21.1, C22.1, C24.1, C25.1, D28.2 (A), D29.2 (A), D30.2 (A), D33.2 (A), D34.2 (A), R23.1, R31.1, R33.1, R35.1, R41.2, R42.1, U2.2 (VCC), U3.8 (VCC); also elsewhere on the board
+12V: R21.2; also elsewhere on the board
GND: C21.2, C22.2, C23.2, C24.2, C25.2, D28.1 (K), D29.1 (K), D31.1 (K), D32.1 (K), D35.2 (A2), D36.2 (A2), Q1.2 (S), R18.2, R22.2, R39.2, R40.2, SW1.2, U2.3 (GND), U3.5 (GND); also elsewhere on the board
MCU_UART2_RX: R33.2, R34.1, U3.1 (RO); also elsewhere on the board
MCU_UART2_TX: R35.2, R36.1, U3.4 (DI); also elsewhere on the board
MCU_button_on_board: R38.2; also elsewhere on the board
MCU_buzzer_out: R37.2; also elsewhere on the board
MCU_one_wire_PIN: D28.3 (K), L2.2, R23.2, R24.2; also elsewhere on the board
MCU_pjon_bus_PIN: D29.3 (K), L3.2, R25.1; also elsewhere on the board
MCU_power_OK_from_ADM705: R30.1; also elsewhere on the board
MCU_rs485_de: R31.2, U3.2 (~RE), U3.3 (DE); also elsewhere on the board
MCU_rst: JP1.2 (B); also elsewhere on the board
MCU_system_status_LED: R32.1; also elsewhere on the board
MCU_wdt_reset_to_ADM705: R29.1; also elsewhere on the board
unnamed: C23.1, R21.1, R27.2, RV1.1, RV1.2, U2.4 (PFI)
unnamed: D30.1 (K), R24.1
unnamed: D31.2 (A), R25.2
unnamed: D32.2 (A), R32.2
unnamed: D33.1 (K), R34.2
unnamed: D34.1 (K), R36.2
unnamed: JP1.1 (A), R28.1
unnamed: L2.1, R19.1
unnamed: L3.1, R20.1
unnamed: LS1.N, Q1.3 (D), R45.2
unnamed: LS1.P, R41.1, R45.1
unnamed: Q1.1 (G), R37.1, R40.1
unnamed: R22.1, RV1.3
unnamed: R26.1, U2.8 (WD0)
unnamed: R26.2, U2.1 (MR)
unnamed: R27.1, R30.2, U2.5 (PFO)
unnamed: R28.2, U2.7 (RST)
unnamed: R29.2, U2.6 (WDI)
unnamed: R38.1, SW1.1
unnamed: R39.1, R43.2, U3.7 (B)
unnamed: R42.2, R44.2, U3.6 (A)
ONE_WARE_INPUT: R19.2; also elsewhere on the board
PJON_BUS: R18.1, R20.2; also elsewhere on the board
RS485_A: D36.1 (A1), R44.1; also elsewhere on the board
RS485_B: D35.1 (A1), R43.1; also elsewhere on the board

Notes on the sheet:
Optional

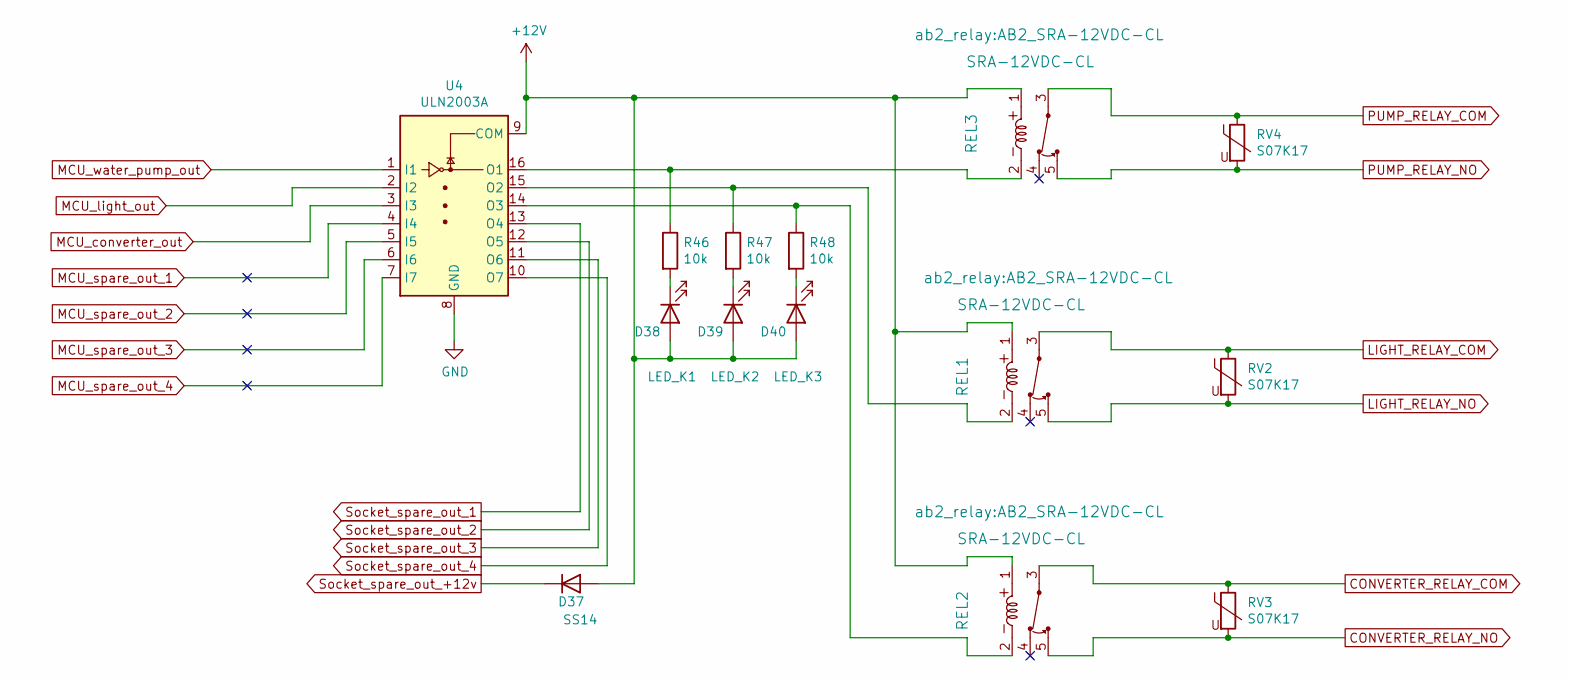
[picture p23: schematic Outputs.sch, Car bs controller nex mega v3]

Parts:
D37: SS14; D_SMA
D38: LED_K1; LED_0603_1608Metric
D39: LED_K2; LED_0603_1608Metric
D40: LED_K3; LED_0603_1608Metric
R46, R47, R48: 10k; R_0603_1608Metric
REL1, REL2, REL3: SRA-12VDC-CL; AB2_SRA-12VDC-CL
RV2, RV3, RV4: S07K17; RV_Disc_D9mm_W3.7mm_P5mm
U4: ULN2003A; SOIC-16_3.9x9.9mm_P1.27mm

Connections:
+12V: D37.1 (A), D38.2 (A), D39.2 (A), D40.2 (A), REL1.1, REL2.1, REL3.1, U4.9 (COM); also elsewhere on the board
CONVERTER_RELAY_COM: REL2.3, RV3.1; also elsewhere on the board
CONVERTER_RELAY_NO: REL2.5, RV3.2; also elsewhere on the board
GND: U4.8 (GND); also elsewhere on the board
LIGHT_RELAY_COM: REL1.3, RV2.1; also elsewhere on the board
LIGHT_RELAY_NO: REL1.5, RV2.2; also elsewhere on the board
MCU_converter_out: U4.3 (I3); also elsewhere on the board
MCU_light_out: U4.2 (I2); also elsewhere on the board
MCU_spare_out_1: U4.4 (I4); also elsewhere on the board
MCU_spare_out_2: U4.5 (I5); also elsewhere on the board
MCU_spare_out_3: U4.6 (I6); also elsewhere on the board
MCU_spare_out_4: U4.7 (I7); also elsewhere on the board
MCU_water_pump_out: U4.1 (I1); also elsewhere on the board
unnamed: D38.1 (K), R46.2
unnamed: D39.1 (K), R47.2
unnamed: D40.1 (K), R48.2
unnamed: R46.1, REL3.2, U4.16 (O1)
unnamed: R47.1, REL1.2, U4.15 (O2)
unnamed: R48.1, REL2.2, U4.14 (O3)
PUMP_RELAY_COM: REL3.3, RV4.1; also elsewhere on the board
PUMP_RELAY_NO: REL3.5, RV4.2; also elsewhere on the board
Socket_spare_out_1: U4.13 (O4); also elsewhere on the board
Socket_spare_out_2: U4.12 (O5); also elsewhere on the board
Socket_spare_out_3: U4.11 (O6); also elsewhere on the board
Socket_spare_out_4: U4.10 (O7); also elsewhere on the board
Socket_spare_out_+12v: D37.2 (K); also elsewhere on the board

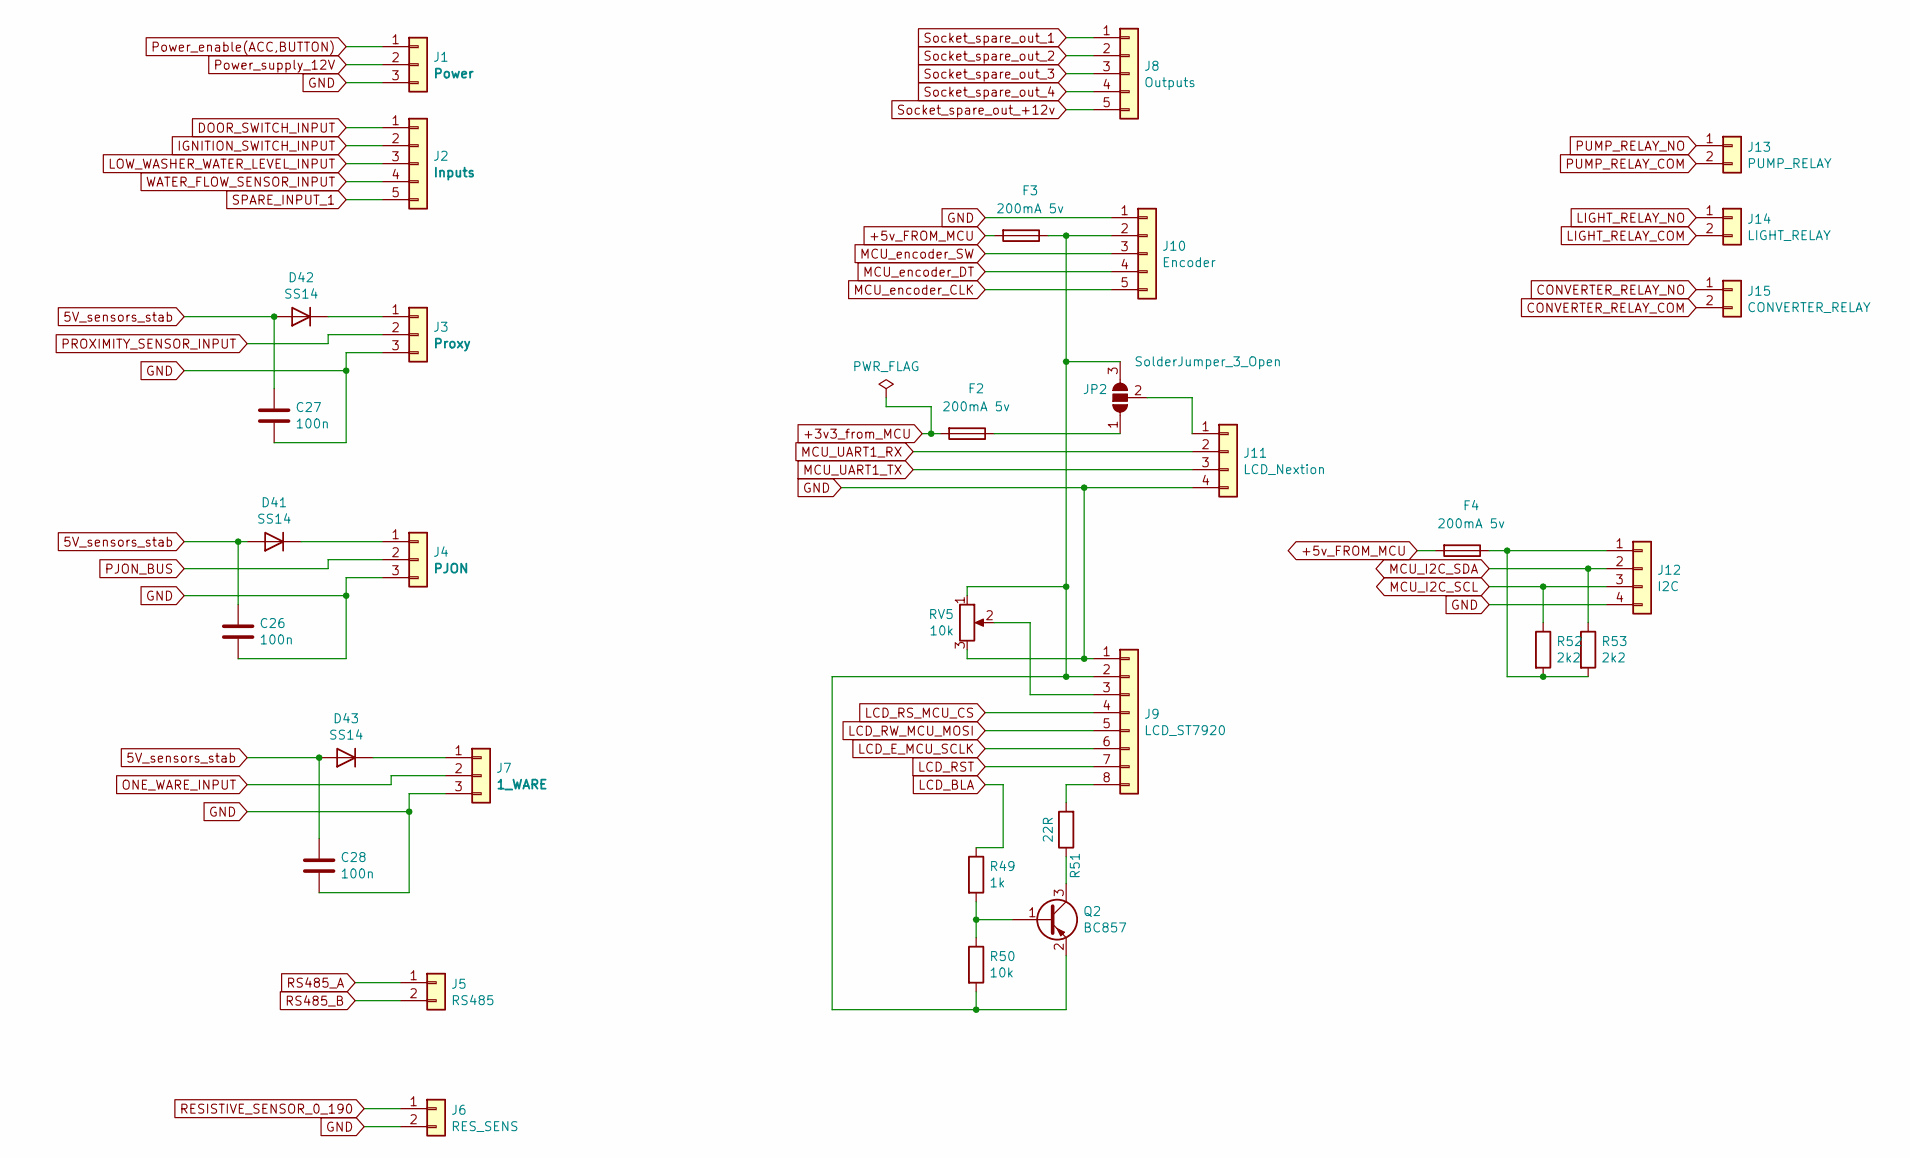
[picture p24: schematic Plugs.sch, Car bs controller nex mega v3]

Parts:
C26, C27, C28: 100n; C_0603_1608Metric
D41, D42, D43: SS14; D_SMA
F2, F3, F4: 200mA 5v; Fuse_1206_3216Metric_Pad1.42x1.75mm_HandSolder
J1: Power; PhoenixContact_MSTBA_2,5_3-G_1x03_P5.00mm_Horizontal
J2: Inputs; PhoenixContact_MC_1,5_5-G-3.81_1x05_P3.81mm_Horizontal
J3: Proxy; PhoenixContact_MC_1,5_3-G-3.81_1x03_P3.81mm_Horizontal
J4: PJON; PhoenixContact_MC_1,5_3-G-3.81_1x03_P3.81mm_Horizontal
J5: RS485; PhoenixContact_MC_1,5_2-G-3.81_1x02_P3.81mm_Horizontal
J6: RES_SENS; PhoenixContact_MC_1,5_2-G-3.81_1x02_P3.81mm_Horizontal
J7: 1_WARE; PhoenixContact_MC_1,5_3-G-3.81_1x03_P3.81mm_Horizontal
J8: Outputs; Hirose_DF13-05P-1.25DS_1x05_P1.25mm_Horizontal
J9: LCD_ST7920; Hirose_DF13-08P-1.25DSA_1x08_P1.25mm_Vertical
J10: Encoder; Hirose_DF13-05P-1.25DSA_1x05_P1.25mm_Vertical
J11: LCD_Nextion; Hirose_DF13-04P-1.25DSA_1x04_P1.25mm_Vertical
J12: I2C; Hirose_DF13-04P-1.25DSA_1x04_P1.25mm_Vertical
J13: PUMP_RELAY; PhoenixContact_MSTBA_2,5_2-G_1x02_P5.00mm_Horizontal
J14: LIGHT_RELAY; PhoenixContact_MSTBA_2,5_2-G_1x02_P5.00mm_Horizontal
J15: CONVERTER_RELAY; PhoenixContact_MSTBA_2,5_2-G_1x02_P5.00mm_Horizontal
JP2: SolderJumper_3_Open; SolderJumper-3_P1.3mm_Open_RoundedPad1.0x1.5mm_NumberLabels
Q2: BC857; SOT-23
R49: 1k; R_0603_1608Metric_Pad0.98x0.95mm_HandSolder
R50: 10k; R_0603_1608Metric_Pad0.98x0.95mm_HandSolder
R51: 22R; R_0805_2012Metric
R52, R53: 2k2; R_0603_1608Metric
RV5: 10k; Potentiometer_Bourns_3314J_Vertical

Connections:
5V_sensors_stab: C26.1, C27.1, C28.1, D41.1 (A), D42.1 (A), D43.1 (A); also elsewhere on the board
+3v3_from_MCU: F2.2; also elsewhere on the board
+5v_FROM_MCU: F3.2, F4.2; also elsewhere on the board
CONVERTER_RELAY_COM: J15.2; also elsewhere on the board
CONVERTER_RELAY_NO: J15.1; also elsewhere on the board
DOOR_SWITCH_INPUT: J2.1; also elsewhere on the board
GND: C26.2, C27.2, C28.2, J1.3, J3.3, J4.3, J6.2, J7.3, J9.1, J10.1, J11.4, J12.4, RV5.3; also elsewhere on the board
IGNITION_SWITCH_INPUT: J2.2; also elsewhere on the board
LCD_BLA: R49.1; also elsewhere on the board
LCD_E_MCU_SCLK: J9.6; also elsewhere on the board
LCD_RST: J9.7; also elsewhere on the board
LCD_RW_MCU_MOSI: J9.5; also elsewhere on the board
LIGHT_RELAY_COM: J14.2; also elsewhere on the board
LIGHT_RELAY_NO: J14.1; also elsewhere on the board
LOW_WASHER_WATER_LEVEL_INPUT: J2.3; also elsewhere on the board
MCU_I2C_SCL: J12.3, R52.1; also elsewhere on the board
MCU_I2C_SDA: J12.2, R53.1; also elsewhere on the board
MCU_UART1_RX: J11.2; also elsewhere on the board
MCU_UART1_TX: J11.3; also elsewhere on the board
MCU_encoder_CLK: J10.5; also elsewhere on the board
MCU_encoder_DT: J10.4; also elsewhere on the board
MCU_encoder_SW: J10.3; also elsewhere on the board
unnamed: D41.2 (K), J4.1
unnamed: D42.2 (K), J3.1
unnamed: D43.2 (K), J7.1
unnamed: F2.1, JP2.1 (A)
unnamed: F3.1, J9.2, J10.2, JP2.3 (B), Q2.2 (E), R50.2, RV5.1
unnamed: F4.1, J12.1, R52.2, R53.2
unnamed: J9.3, RV5.2
unnamed: J9.8, R51.2
unnamed: J11.1, JP2.2 (C)
unnamed: Q2.1 (B), R49.2, R50.1
unnamed: Q2.3 (C), R51.1
ONE_WARE_INPUT: J7.2; also elsewhere on the board
PJON_BUS: J4.2; also elsewhere on the board
PROXIMITY_SENSOR_INPUT: J3.2; also elsewhere on the board
PUMP_RELAY_COM: J13.2; also elsewhere on the board
PUMP_RELAY_NO: J13.1; also elsewhere on the board
Power_enable(ACC,BUTTON): J1.1; also elsewhere on the board
Power_supply_12V: J1.2; also elsewhere on the board
RESISTIVE_SENSOR_0_190: J6.1; also elsewhere on the board
RS485_A: J5.1; also elsewhere on the board
RS485_B: J5.2; also elsewhere on the board
SPARE_INPUT_1: J2.5; also elsewhere on the board
Socket_spare_out_1: J8.1; also elsewhere on the board
Socket_spare_out_2: J8.2; also elsewhere on the board
Socket_spare_out_3: J8.3; also elsewhere on the board
Socket_spare_out_4: J8.4; also elsewhere on the board
Socket_spare_out_+12v: J8.5; also elsewhere on the board
WATER_FLOW_SENSOR_INPUT: J2.4; also elsewhere on the board
