Golowa70/CAR_BS_CONTROLLER_ST7920/KiCad/Car_bs_controller_nex_mega/Car_bs_controller_nex_mega.kicad_pcb

## KiCad design KiCad/Car_bs_controller_nex_mega/Car_bs_controller_nex_mega.kicad_pcb (continued)

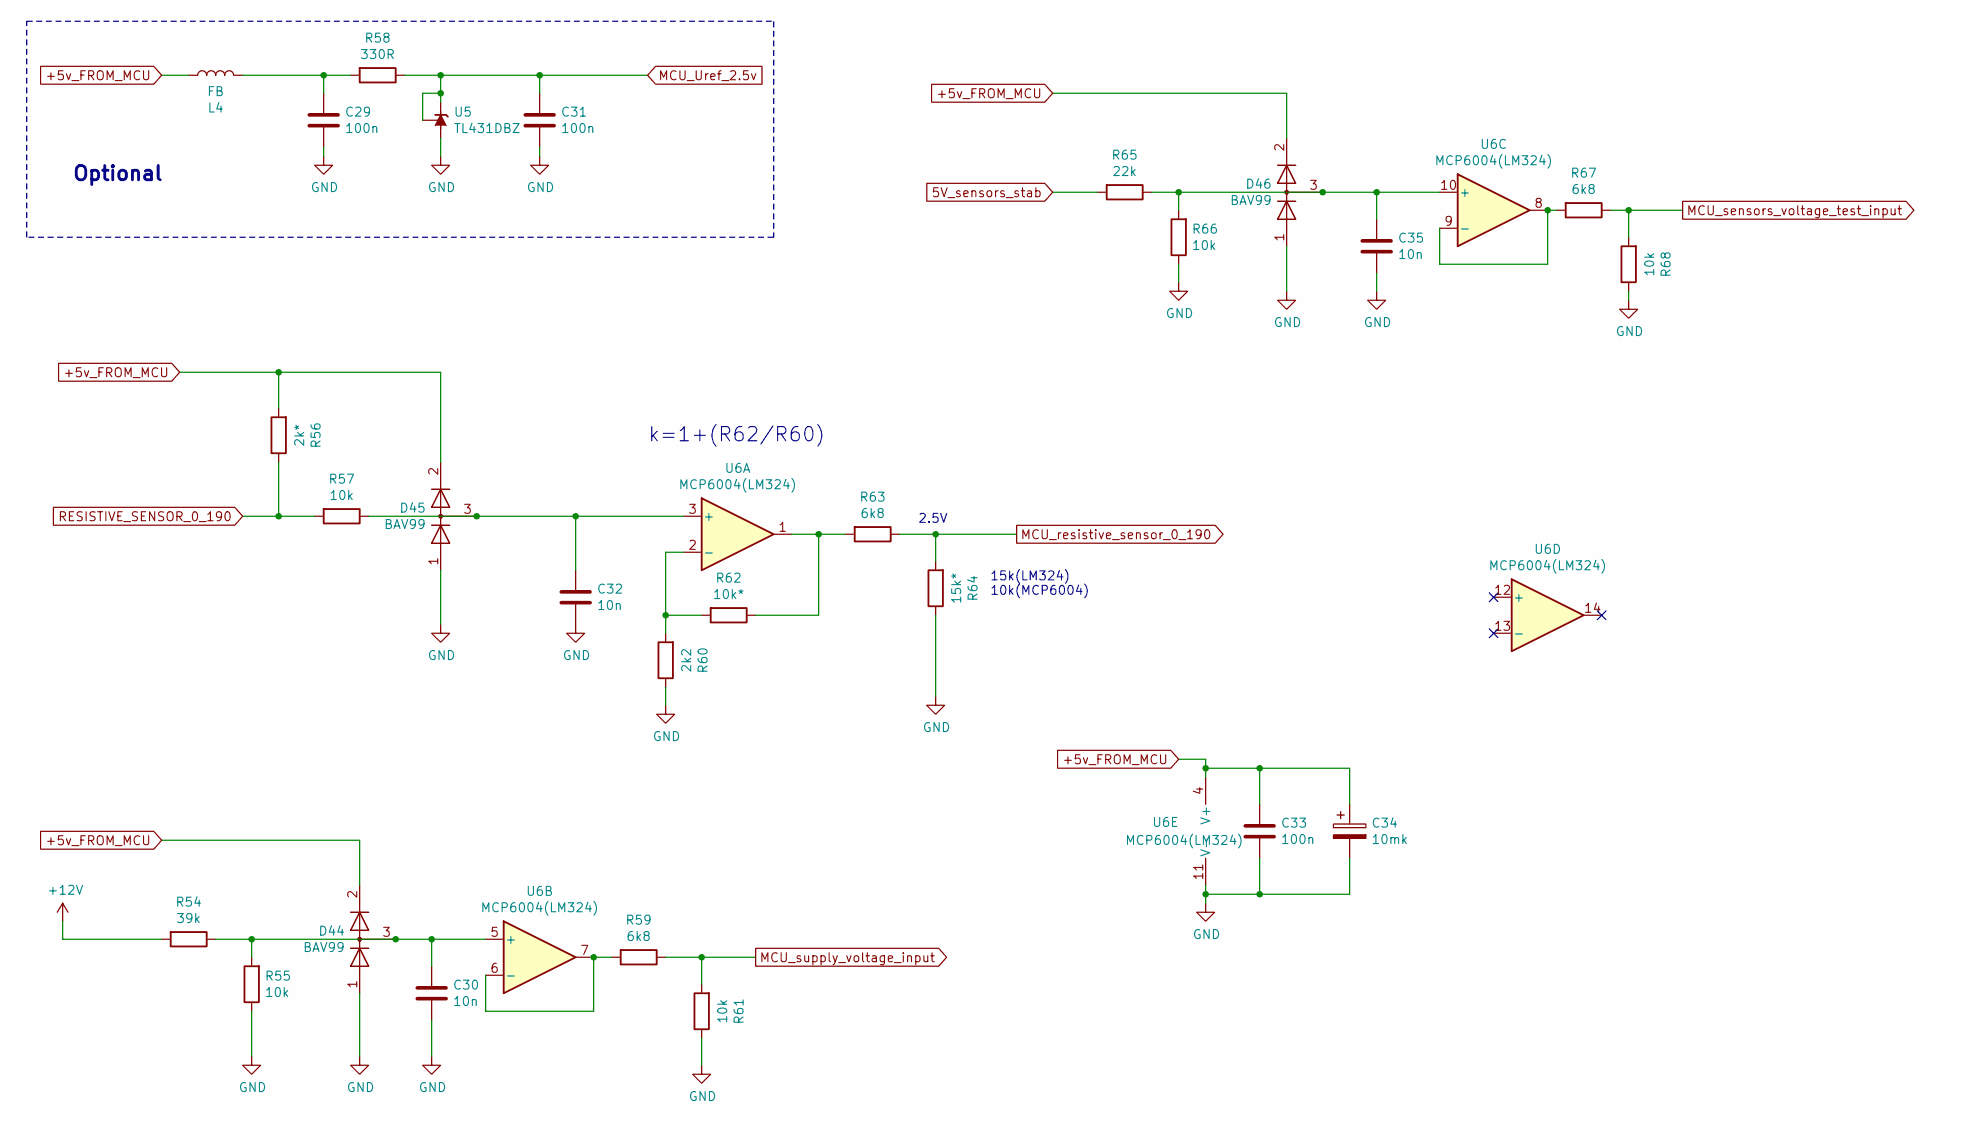
[picture p25: schematic Analog_input.sch, Car bs controller nex mega v3]

Parts:
C29, C31, C33: 100n; R_0603_1608Metric
C30, C32, C35: 10n; R_0603_1608Metric
C34: 10mk; CP_EIA-6032-15_Kemet-U
D44, D45, D46: BAV99; SOT-23
L4: FB; L_1206_3216Metric_Pad1.42x1.75mm_HandSolder
R54: 39k; R_0603_1608Metric_Pad0.98x0.95mm_HandSolder
R55, R57, R61, R66, R68: 10k; R_0603_1608Metric_Pad0.98x0.95mm_HandSolder
R56: 2k*; R_0805_2012Metric
R58: 330R; R_0805_2012Metric
R59, R63, R67: 6k8; R_0603_1608Metric_Pad0.98x0.95mm_HandSolder
R60: 2k2; R_0603_1608Metric_Pad0.98x0.95mm_HandSolder
R62: 10k*; R_0603_1608Metric_Pad0.98x0.95mm_HandSolder
R64: 15k*; R_0603_1608Metric_Pad0.98x0.95mm_HandSolder
R65: 22k; R_0603_1608Metric_Pad0.98x0.95mm_HandSolder
U5: TL431DBZ; SOT-23
U6: MCP6004(LM324); SOIC-14_3.9x8.7mm_P1.27mm

Connections:
5V_sensors_stab: R65.2; also elsewhere on the board
+5v_FROM_MCU: C33.1, C34.1, D44.2 (A), D45.2 (A), D46.2 (A), L4.1, R56.2, U6.4 (V+); also elsewhere on the board
+12V: R54.2; also elsewhere on the board
GND: C29.2, C30.2, C31.2, C32.2, C33.2, C34.2, C35.2, D44.1 (K), D45.1 (K), D46.1 (K), R55.1, R60.1, R61.1, R64.1, R66.1, R68.1, U5.3 (A), U6.11 (V-); also elsewhere on the board
MCU_Uref_2.5v: C31.1, R58.1, U5.1 (K), U5.2 (REF); also elsewhere on the board
MCU_resistive_sensor_0_190: R63.1, R64.2; also elsewhere on the board
MCU_sensors_voltage_test_input: R67.1, R68.2; also elsewhere on the board
MCU_supply_voltage_input: R59.1, R61.2; also elsewhere on the board
unnamed: C29.1, L4.2, R58.2
unnamed: C30.1, D44.3 (K), R54.1, R55.2, U6.5 (+)
unnamed: C32.1, D45.3 (K), R57.1, U6.3 (+)
unnamed: C35.1, D46.3 (K), R65.1, R66.2, U6.10 (+)
unnamed: R59.2, U6.6 (-), U6.7
unnamed: R60.2, R62.2, U6.2 (-)
unnamed: R62.1, R63.2, U6.1
unnamed: R67.2, U6.8, U6.9 (-)
RESISTIVE_SENSOR_0_190: R56.1, R57.2; also elsewhere on the board

Notes on the sheet:
k=1+(R62/R60)
15k(LM324) 10k(MCP6004)
2.5V
Optional

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
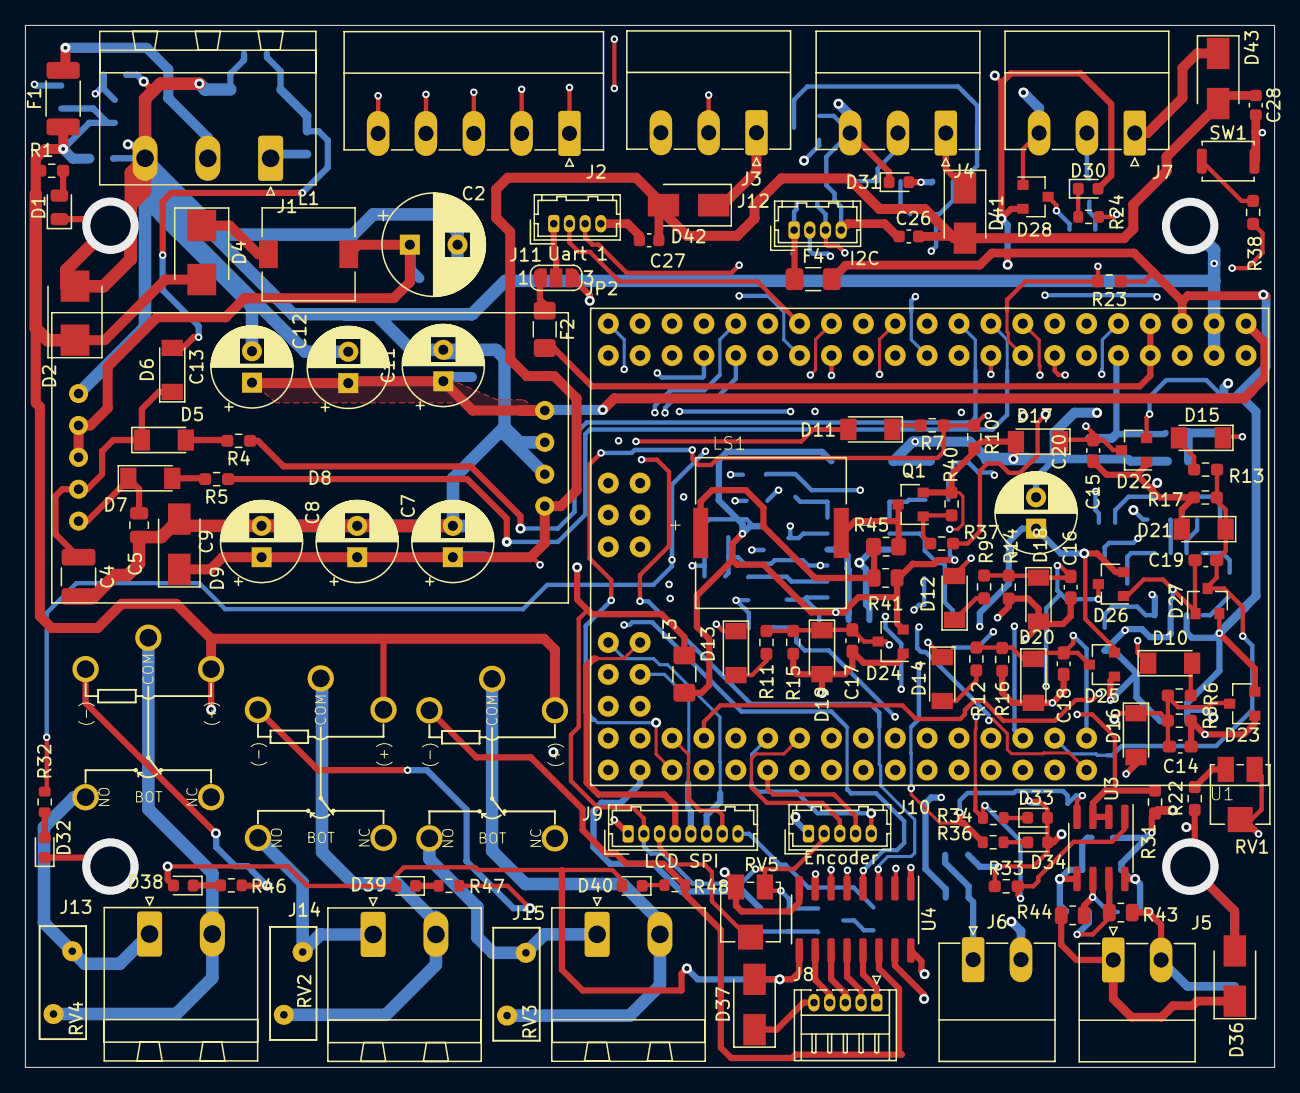
[picture p26: board Car_bs_controller_nex_mega.kicad_pcb from above]

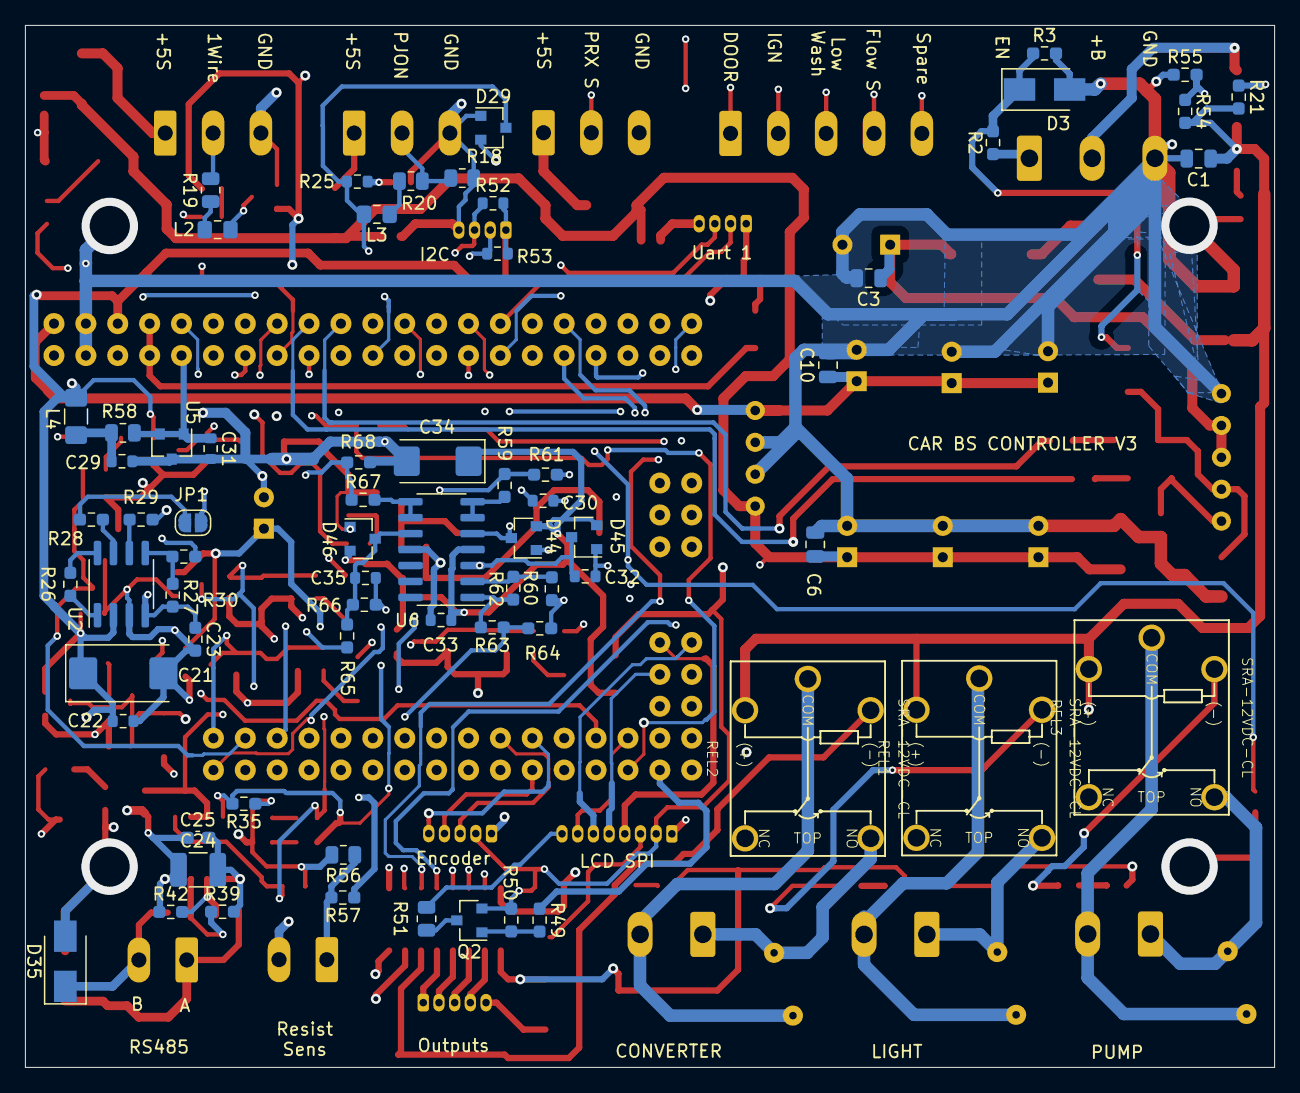
[picture p27: board Car_bs_controller_nex_mega.kicad_pcb from below]

Board: 4 copper layers, 99.5 x 83.0 mm, 192 parts (68 on the bottom side), 132 nets.
