Golowa70/CAR_BS_CONTROLLER_ST7920/KiCad/Cbc_power_supply_module/Cbc_power_supply_module.kicad_pcb

## KiCad design KiCad/Cbc_power_supply_module/Cbc_power_supply_module.kicad_pcb (2022-05-16)

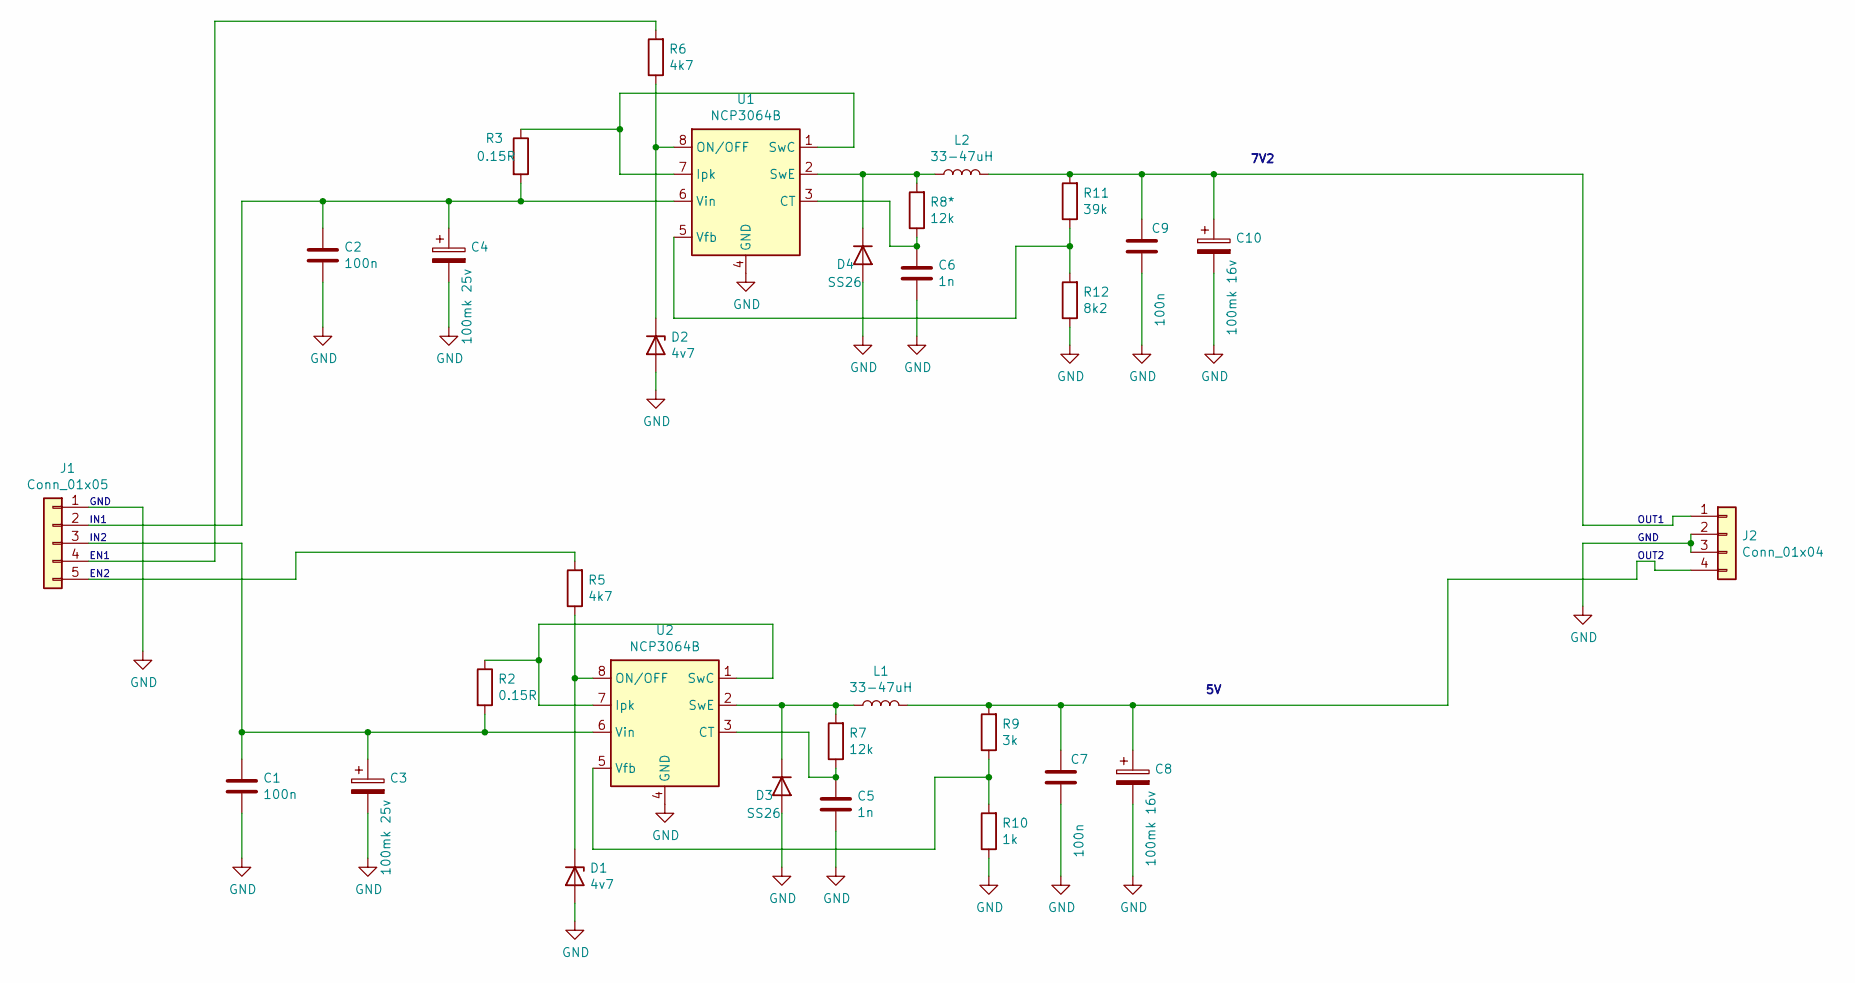
[picture p28: schematic Cbc_power_supply_module.sch, 2xNCP3064B]

Parts:
C1, C2, C7, C9: 100n; C_0805_2012Metric_Pad1.18x1.45mm_HandSolder
C3, C4: 100mk 25v; CP_Radial_D8.0mm_P3.80mm
C5, C6: 1n; C_0805_2012Metric_Pad1.18x1.45mm_HandSolder
C8, C10: 100mk 16v; CP_Radial_D8.0mm_P3.80mm
D1, D2: 4v7; D_MiniMELF
D3, D4: SS26; D_SMB
J1: Conn_01x05; PinHeader_1x05_P2.54mm_Vertical
J2: Conn_01x04; PinHeader_1x04_P2.54mm_Vertical
L1, L2: 33-47uH; L_7.3x7.3_H4.5
R2, R3: 0.15R; R_1210_3225Metric_Pad1.30x2.65mm_HandSolder
R5, R6: 4k7; R_0603_1608Metric_Pad0.98x0.95mm_HandSolder
R7, R8*: 12k; R_0805_2012Metric_Pad1.20x1.40mm_HandSolder
R9: 3k; R_0805_2012Metric_Pad1.20x1.40mm_HandSolder
R10: 1k; R_0805_2012Metric_Pad1.20x1.40mm_HandSolder
R11: 39k; R_0805_2012Metric_Pad1.20x1.40mm_HandSolder
R12: 8k2; R_0805_2012Metric_Pad1.20x1.40mm_HandSolder
U1, U2: NCP3064B; SOIC-8_3.9x4.9mm_P1.27mm

Connections:
GND: C1.2, C2.2, C3.2, C4.2, C5.2, C6.2, C7.2, C8.2, C9.2, C10.2, D1.2 (A), D2.2 (A), D3.2 (A), D4.2 (A), J1.1, J2.2, J2.3, R10.1, R12.1, U1.4 (GND), U2.4 (GND)
unnamed: C1.1, C3.1, J1.3, R2.2, U2.6 (Vin)
unnamed: C2.1, C4.1, J1.2, R3.2, U1.6 (Vin)
unnamed: C5.1, R7.1, U2.3 (CT)
unnamed 4: C6.1, R8*.1, U1.3 (CT); also elsewhere on the board
unnamed: C7.1, C8.1, J2.4, L1.2, R9.2
unnamed: C9.1, C10.1, J2.1, L2.2, R11.2
unnamed: D1.1 (K), R5.1, U2.8 (ON/OFF)
unnamed: D2.1 (K), R6.1, U1.8 (ON/OFF)
unnamed: D3.1 (K), L1.1, R7.2, U2.2 (SwE)
unnamed 10: D4.1 (K), L2.1, R8*.2, U1.2 (SwE); also elsewhere on the board
unnamed: J1.4, R6.2
unnamed: J1.5, R5.2
unnamed: R2.1, U2.1 (SwC), U2.7 (Ipk)
unnamed: R3.1, U1.1 (SwC), U1.7 (Ipk)
unnamed: R9.1, R10.2, U2.5 (Vfb)
unnamed: R11.1, R12.2, U1.5 (Vfb)

Notes on the sheet:
7V2
GND
IN1
OUT1
EN1
IN2
OUT2
EN2

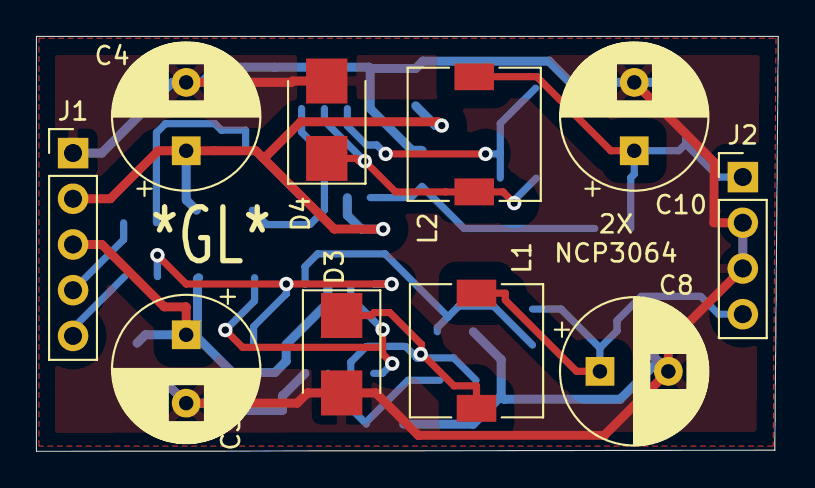
[picture p29: board Cbc_power_supply_module.kicad_pcb from above]

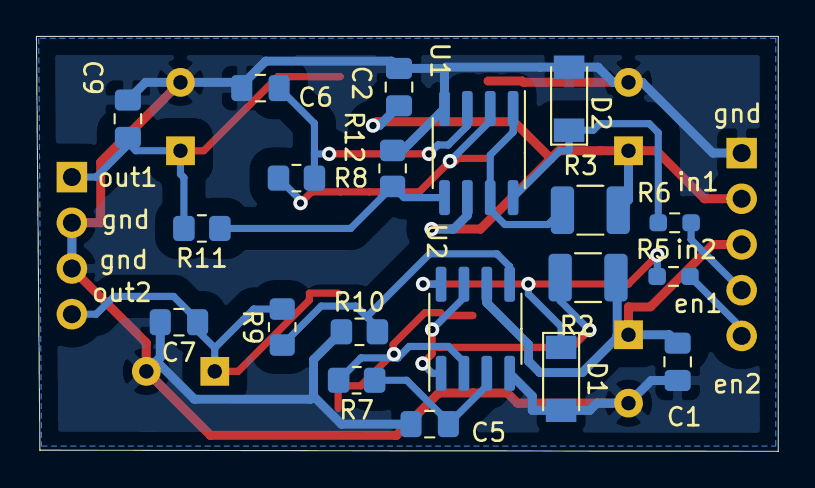
[picture p30: board Cbc_power_supply_module.kicad_pcb from below]

Board: 2 copper layers, 41.2 x 23.1 mm, 30 parts (20 on the bottom side), 17 nets.

Other parts of the board:
R8: 12k; R_0805_2012Metric_Pad1.20x1.40mm_HandSolder

Their connections:
unnamed 4: R8.1; also elsewhere on the board
unnamed 10: R8.2; also elsewhere on the board
